fl0m0/KiCad_libs/3dmodels/Capacitor_SMD_Wurth/CP_Wurth_WCAP-ASLI-D4L5.5.step

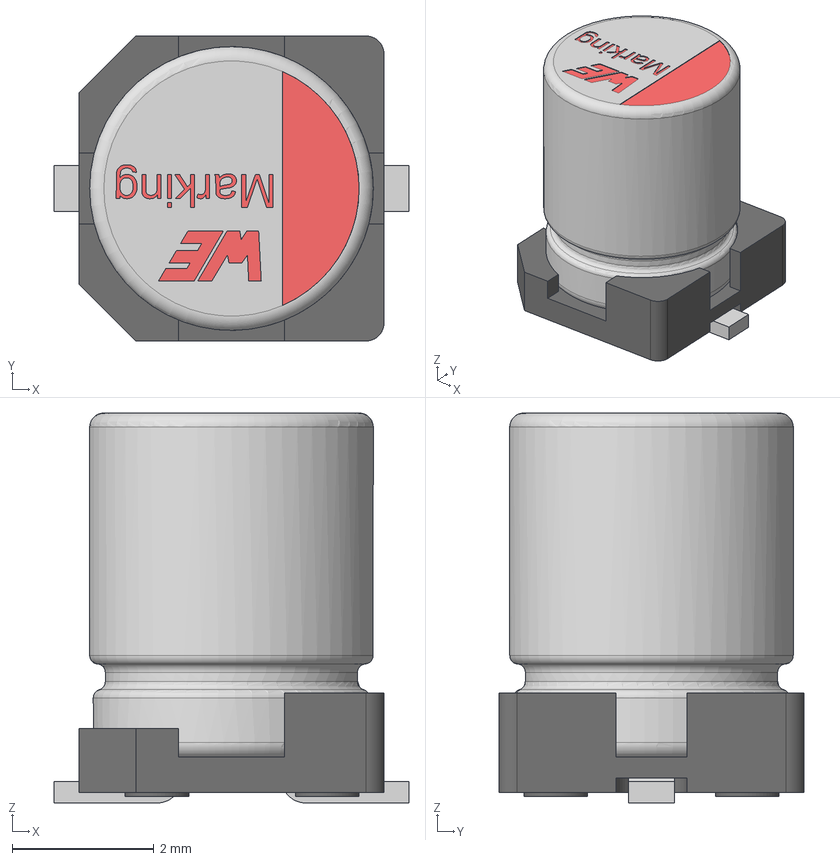
[picture p1: CAD file, 2025-03-17]
3dmodels/Capacitor_SMD_Wurth/CP_Wurth_WCAP-ASLI-D4L5.5.step
5.00 x 4.30 x 5.50 mm
