fl0m0/KiCad_libs/3dmodels/Connector/Harwin_M20-7810445.step

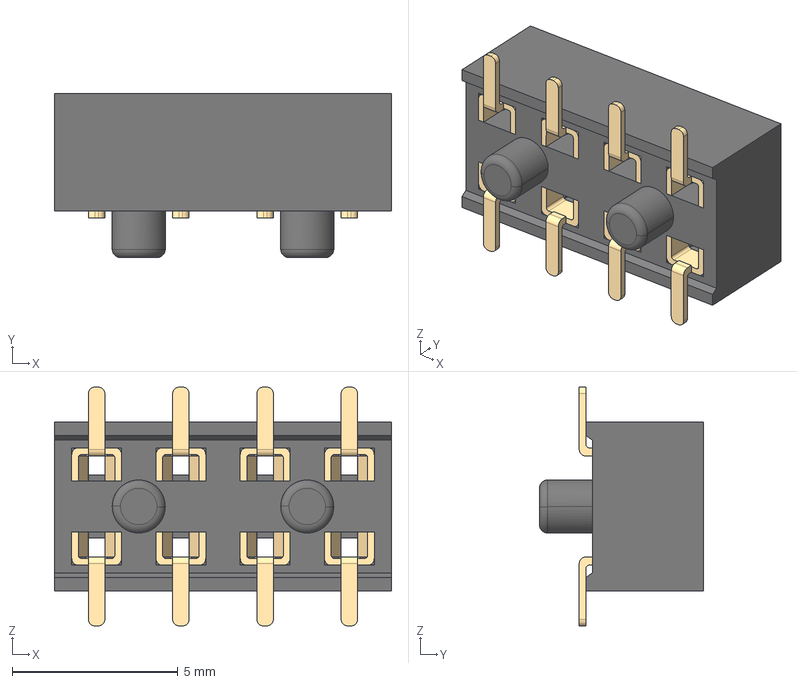
[picture p2: CAD file, 2026-03-09]
3dmodels/Connector/Harwin_M20-7810445.step
10.2 x 4.95 x 7.20 mm
