fl0m0/KiCad_libs/3dmodels/Display_7Segment_User/SA-SC56-11.STEP

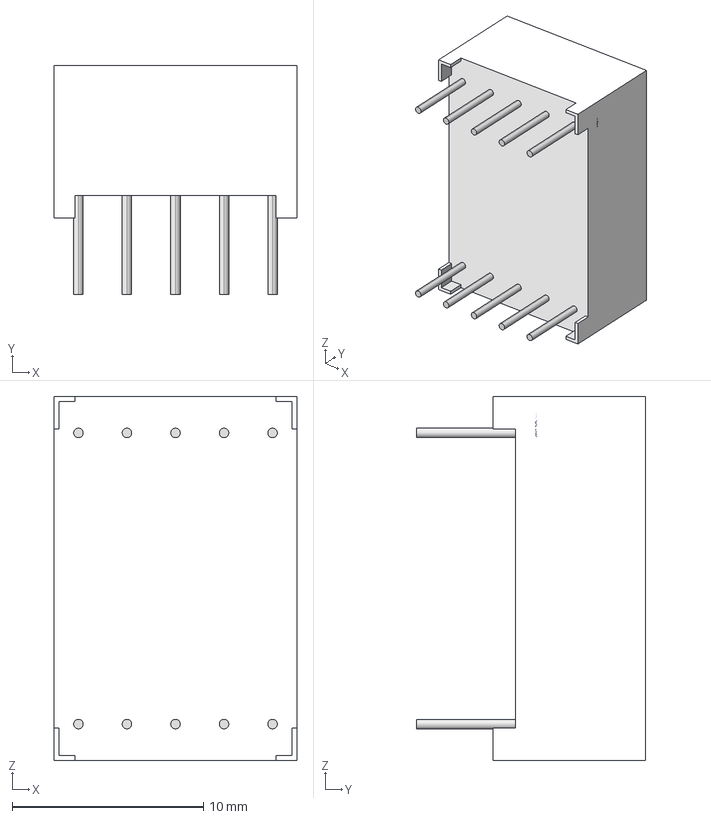
[picture p3: CAD file, 2024-05-18]
3dmodels/Display_7Segment_User/SA-SC56-11.STEP
12.7 x 12.0 x 19.1 mm
