fl0m0/KiCad_libs/3dmodels/Display_User/SSD1306_0.96_OLED.STEP

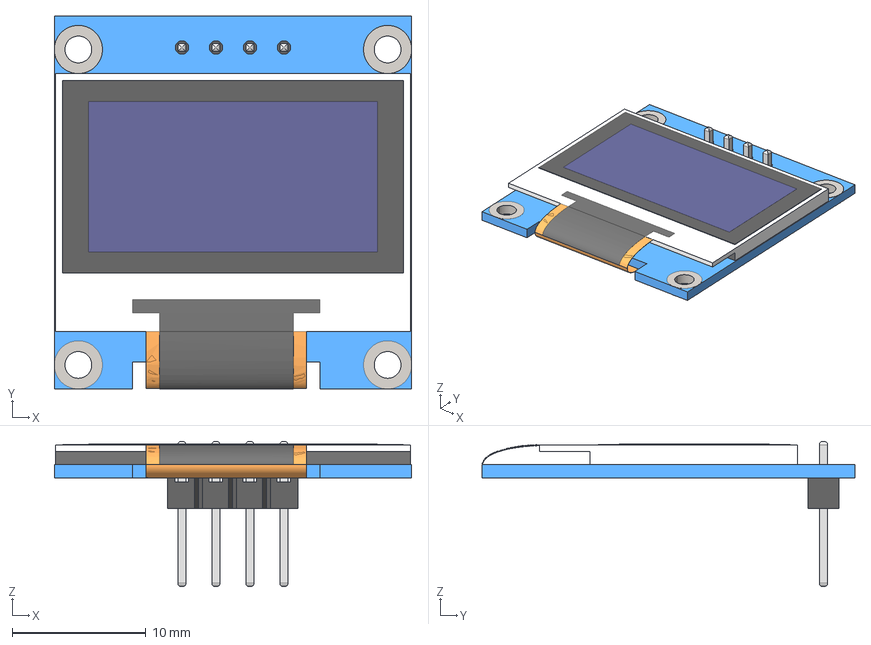
[picture p4: CAD file, 2026-02-07]
3dmodels/Display_User/SSD1306_0.96_OLED.STEP
26.7 x 27.9 x 10.8 mm
48C996C4-7BE9-43D2-ACA2-395FA91DDC79
48C996C4-7BE9-43D2-ACA2-395FA91DDC080
48C996C4-7BE9-43D2-ACA2-395FA91DDC081
48C996C4-7BE9-43D2-ACA2-395FA91DDC082
