fl0m0/KiCad_libs/3dmodels/Inductor/L_Bourns_SRP4020TA_4.45x4.06mm.step

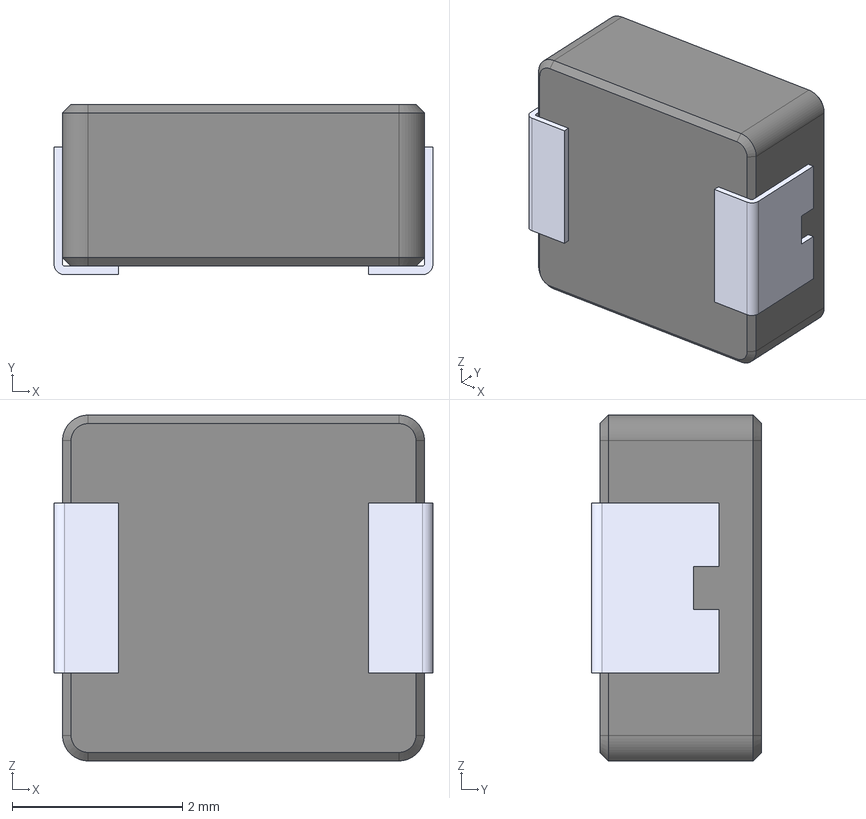
[picture p5: CAD file, 2026-02-13]
3dmodels/Inductor/L_Bourns_SRP4020TA_4.45x4.06mm.step
4.45 x 2.00 x 4.06 mm
SRP4020TA-2R2M
SRP4020TA-2R2M001
SRP4020TA-2R2M002
