fl0m0/KiCad_libs/3dmodels/LED/LTST-C191KFKT_Yellow.step

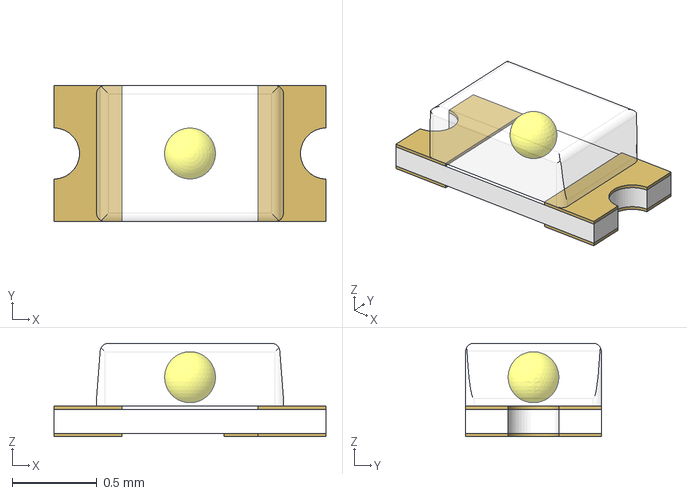
[picture p6: CAD file, 2023-05-30]
3dmodels/LED/LTST-C191KFKT_Yellow.step
1.60 x 0.8 x 0.55 mm
