fl0m0/KiCad_libs/3dmodels/LogicBricks/Wuerth_WR-PHD_61300421821.stp

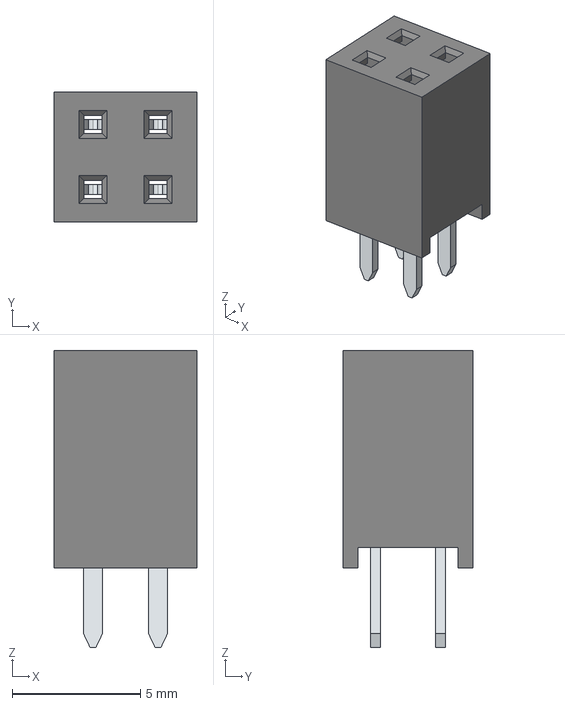
[picture p7: CAD file, 2024-05-12]
3dmodels/LogicBricks/Wuerth_WR-PHD_61300421821.stp
5.58 x 5.08 x 11.6 mm
6130xx21821_PIN x 4
