fl0m0/KiCad_libs/3dmodels/Mechanical/PIHER_5214.step

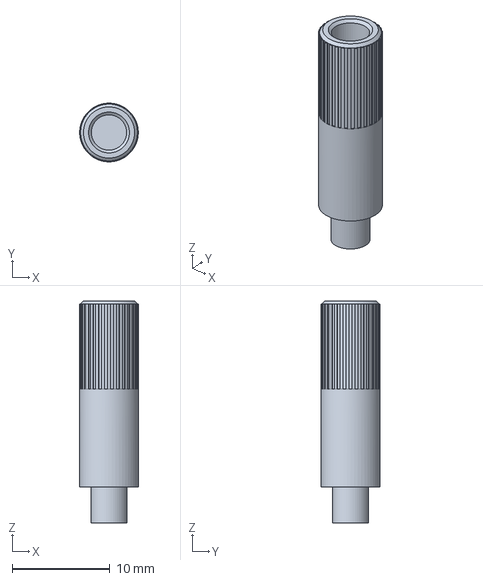
[picture p8: CAD file, 2024-05-27]
3dmodels/Mechanical/PIHER_5214.step
6.00 x 6.00 x 22.7 mm
