fl0m0/KiCad_libs/3dmodels/Module/BTT_TMC2209-V1.2.STEP

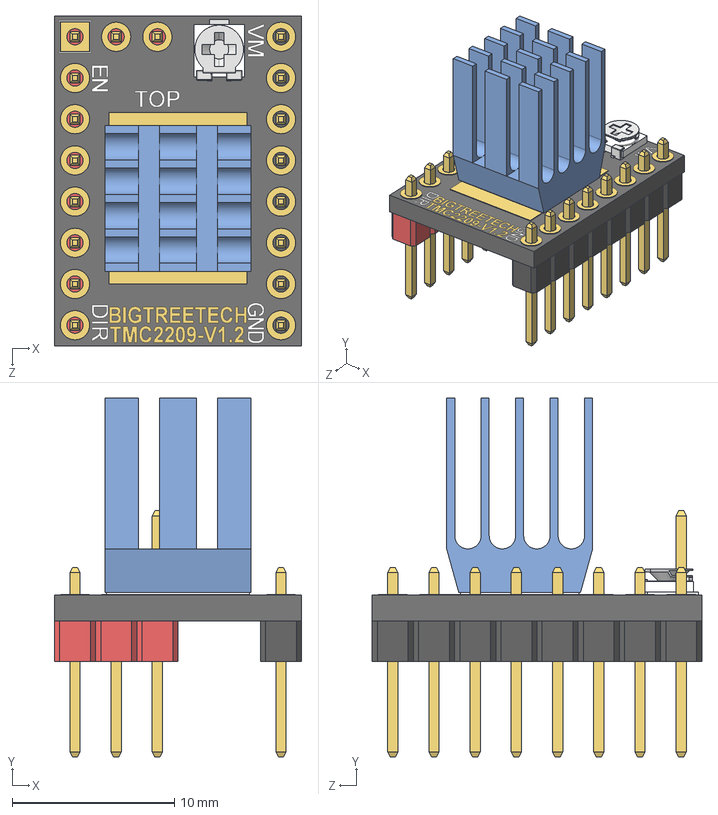
[picture p9: CAD file, 2025-10-17]
3dmodels/Module/BTT_TMC2209-V1.2.STEP
15.2 x 22.1 x 20.3 mm
TMC2209_board
Pin_Header_1x2_red
Pin_Header_1x8_red
Pin_Header_1x8_black
EVM-3E___ _________
TMC2209_heatsink
