fl0m0/KiCad_libs/3dmodels/Package_DFN_QFN/Silicon_Labs_QFN-32-1EP_5x5mm_P0.5mm_EP3.6x3.6mm.step

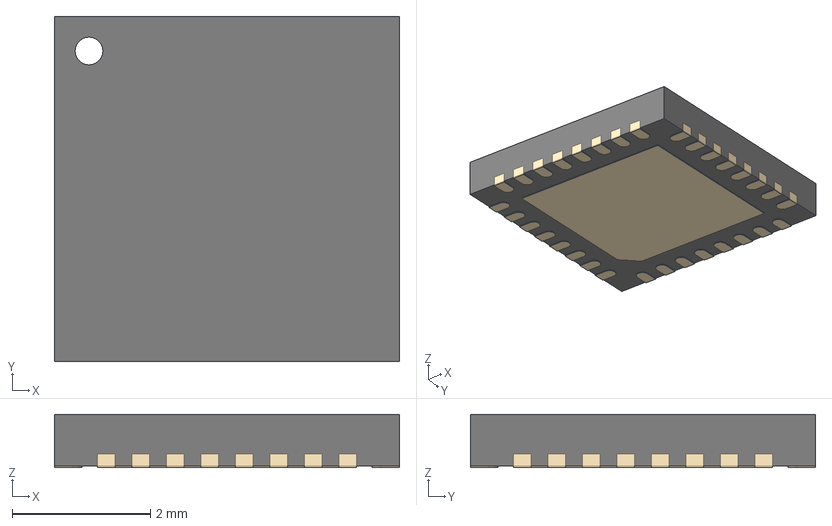
[picture p10: CAD file, 2026-03-19]
3dmodels/Package_DFN_QFN/Silicon_Labs_QFN-32-1EP_5x5mm_P0.5mm_EP3.6x3.6mm.step
5.00 x 5.00 x 0.77 mm
