fl0m0/KiCad_libs/3dmodels/Package_SO/HTSSOP28_EP.STEP

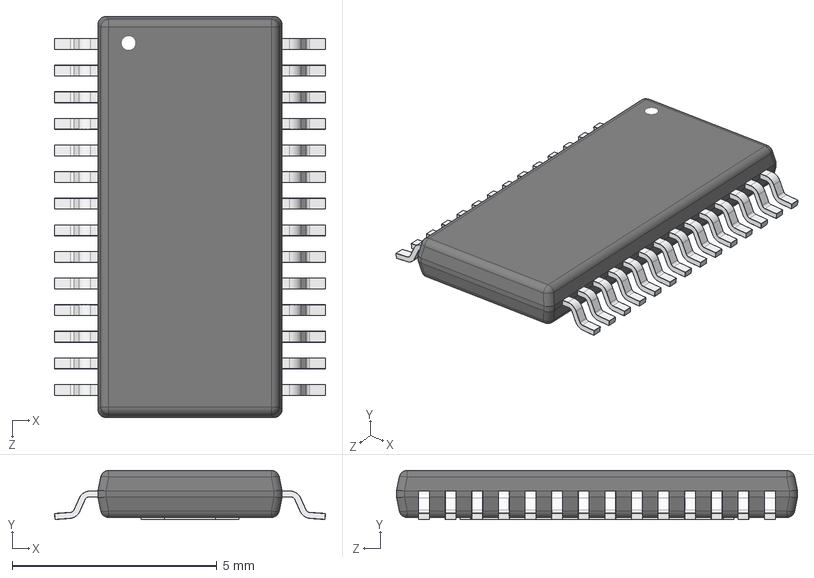
[picture p11: CAD file, 2023-05-30]
3dmodels/Package_SO/HTSSOP28_EP.STEP
6.62 x 1.20 x 9.80 mm
PWP_Koerper
PWP_PIN x 28
PWP_THERM_PIN
