fl0m0/KiCad_libs/3dmodels/Package_SON/Infineon_PG-TDSON-8-33.step

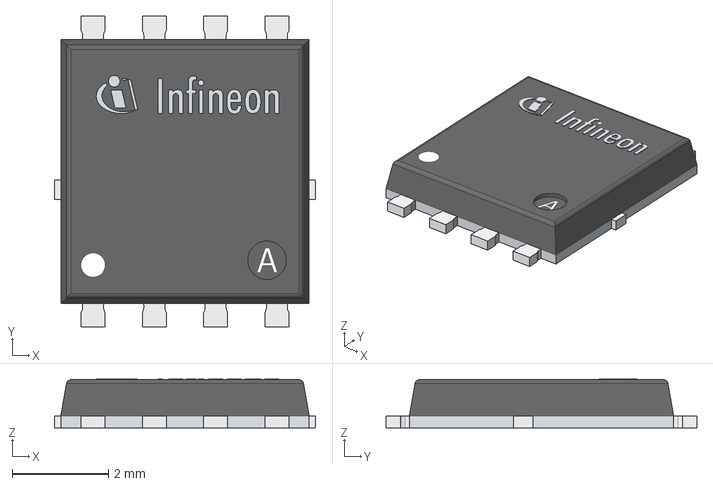
[picture p12: CAD file, 2025-03-15]
3dmodels/Package_SON/Infineon_PG-TDSON-8-33.step
5.41 x 6.44 x 1.01 mm
