fl0m0/KiCad_libs/3dmodels/Potentiometer/PIHER_PT15-NV17.step

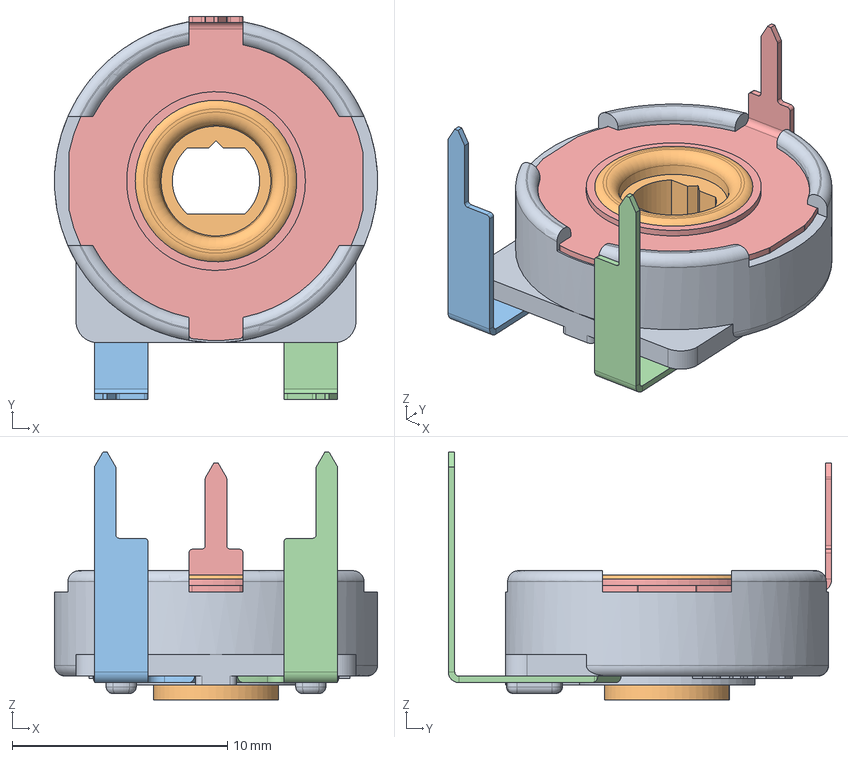
[picture p13: CAD file, 2024-05-25]
3dmodels/Potentiometer/PIHER_PT15-NV17.step
15.0 x 17.8 x 11.5 mm
PT15NV17-CARCASA_REMACHADA
PT15NV17-PORTACURSOR_REMACHADO
PT15NV17-TERMINAL DERECHO
PT15NV17-TERMINAL IZQUIERDO
PT15NV17-COLECTOR_PREDETERMINADA
