fl0m0/KiCad_libs/3dmodels/Relay/jw1.step

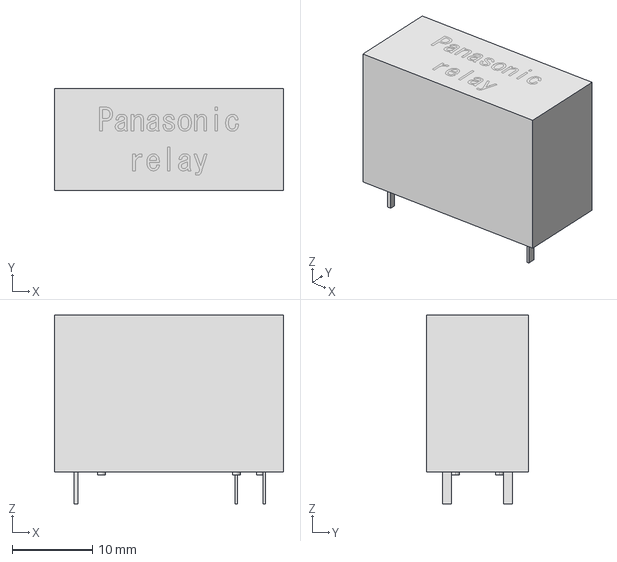
[picture p14: CAD file, 2023-05-30]
3dmodels/Relay/jw1.step
28.6 x 12.8 x 23.6 mm
