fl0m0/KiCad_libs/3dmodels/Rotary_Encoder/PEC11R-4215F-Sxxxx.step

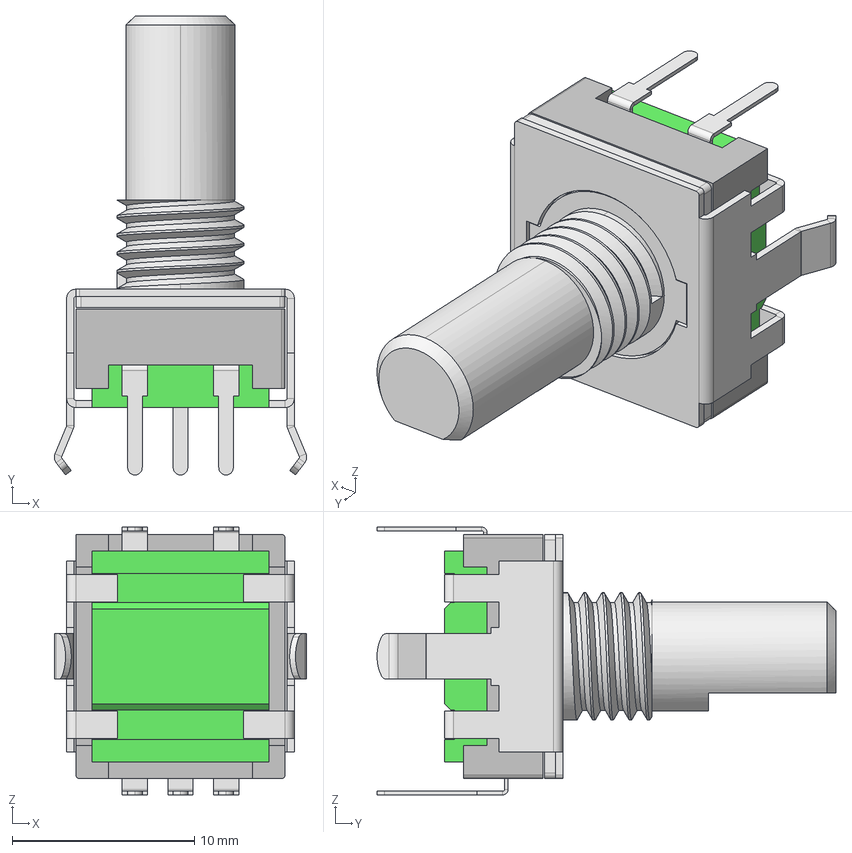
[picture p15: CAD file, 2026-02-07]
3dmodels/Rotary_Encoder/PEC11R-4215F-Sxxxx.step
13.9 x 25.2 x 14.7 mm
PEC11R-4215F-S0024
PEC11R-4215F-S0025
PEC11R-4215F-S0026
PEC11R-4215F-S0027
PEC11R-4215F-S0028
PEC11R-4215F-S0029
PEC11R-4215F-S0030
PEC11R-4215F-S0031
PEC11R-4215F-S0032
