fl0m0/KiCad_libs/3dmodels/Switch/OMRON_B3FS_100x.step

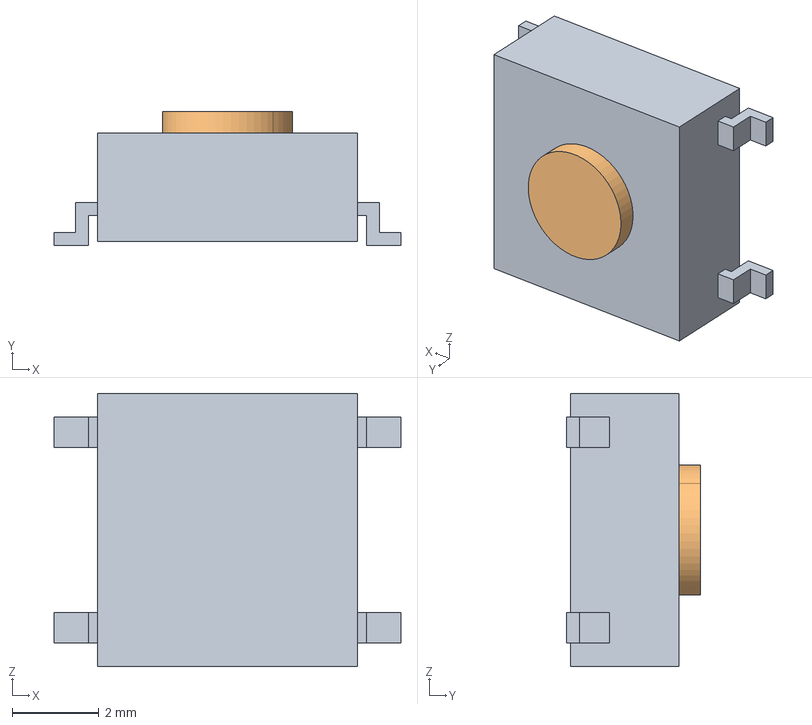
[picture p16: CAD file, 2025-03-22]
3dmodels/Switch/OMRON_B3FS_100x.step
8.00 x 3.10 x 6.30 mm
B3FS_1000_BASE
B3FS_1000_BUTTON
