fl0m0/KiCad_libs/3dmodels/Transformer/Wuerth_WE-FB_3751_EE35_18_10.step

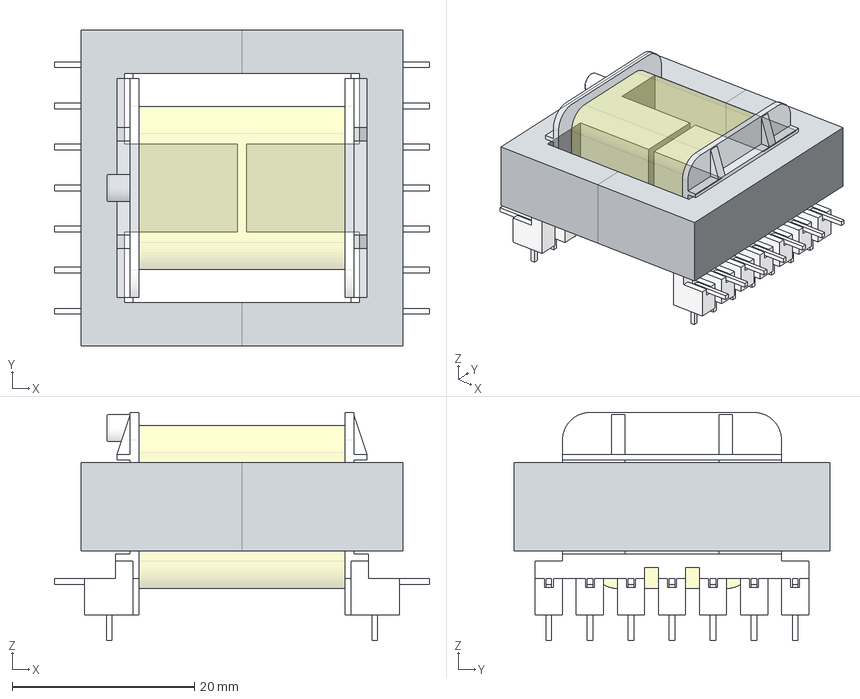
[picture p17: CAD file, 2025-03-12]
3dmodels/Transformer/Wuerth_WE-FB_3751_EE35_18_10.step
41.1 x 34.6 x 25.0 mm
Bobbin_EE-35
core x 2
