fl0m0/KiCad_libs/3dmodels/Capacitor_SMD_Wurth/CP_Wurth_WCAP-ASLI-D8L6.5.step

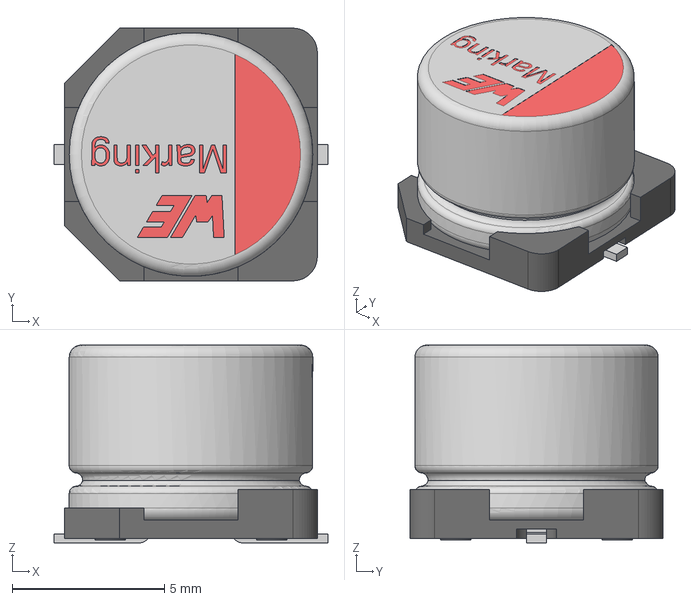
[picture p18: CAD file, 2025-03-17]
3dmodels/Capacitor_SMD_Wurth/CP_Wurth_WCAP-ASLI-D8L6.5.step
9.00 x 8.30 x 6.50 mm
