fl0m0/KiCad_libs/3dmodels/Connector/Wuerth_WR-PHD_61300415721.step

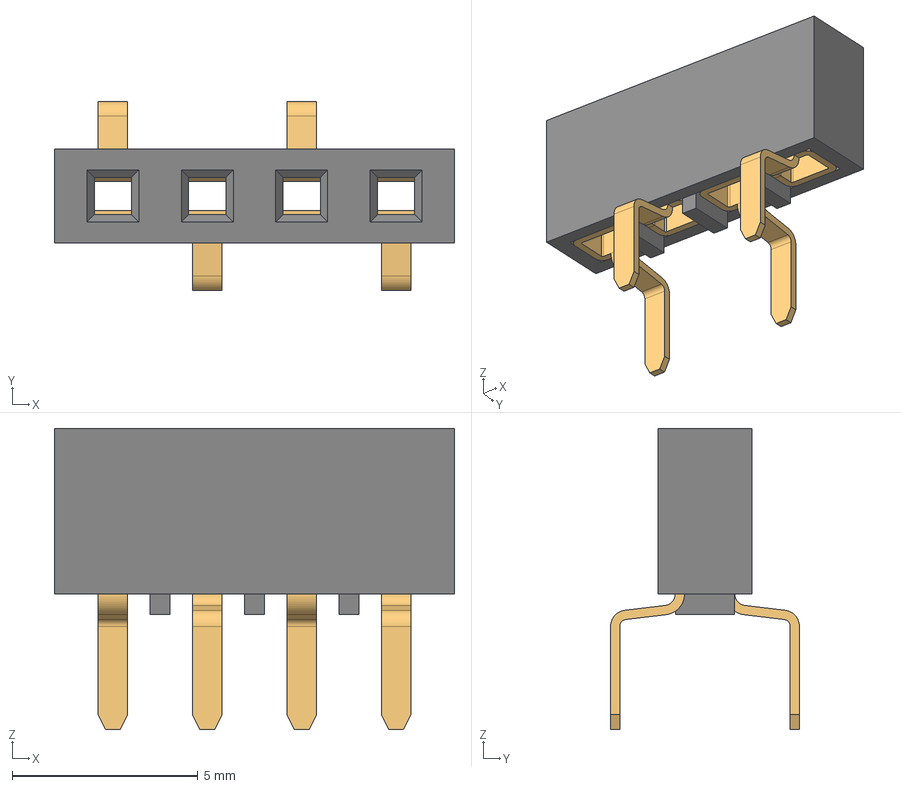
[picture p19: CAD file, 2026-03-08]
3dmodels/Connector/Wuerth_WR-PHD_61300415721.step
10.8 x 5.08 x 8.10 mm
