fl0m0/KiCad_libs/3dmodels/Inductor/L_Wurth_WE-MAPI-4020.step

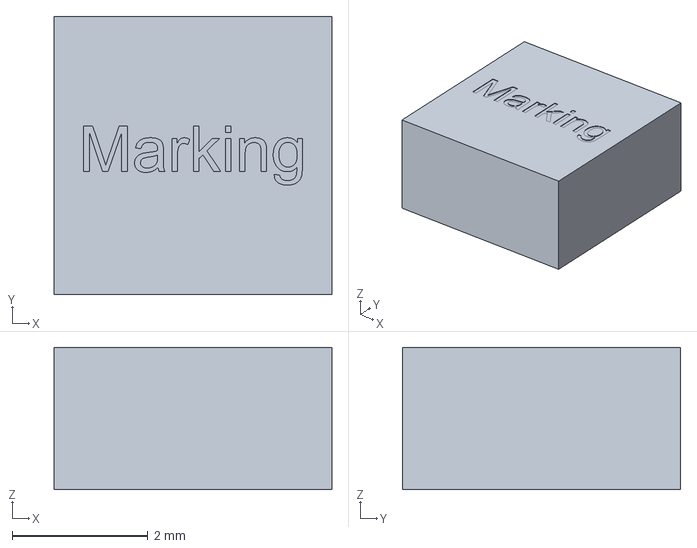
[picture p20: CAD file, 2024-11-29]
3dmodels/Inductor/L_Wurth_WE-MAPI-4020.step
4.10 x 4.10 x 2.10 mm
