fl0m0/KiCad_libs/3dmodels/LED/STW8Q14D.STEP

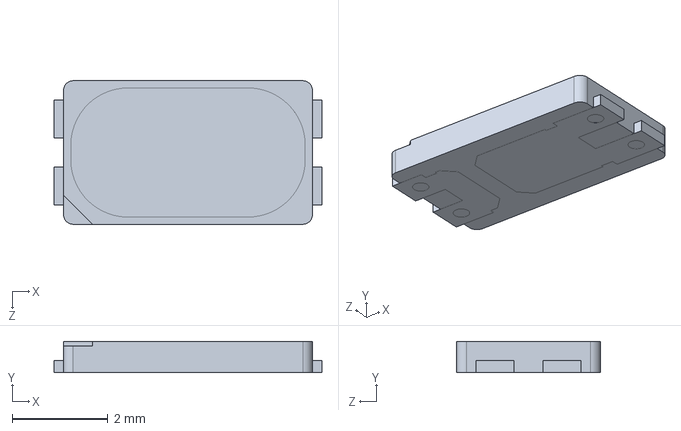
[picture p21: CAD file, 2023-05-30]
3dmodels/LED/STW8Q14D.STEP
5.60 x 0.652 x 3.00 mm
