fl0m0/KiCad_libs/3dmodels/Mechanical/DBG8_CON_Light_Pipe.step

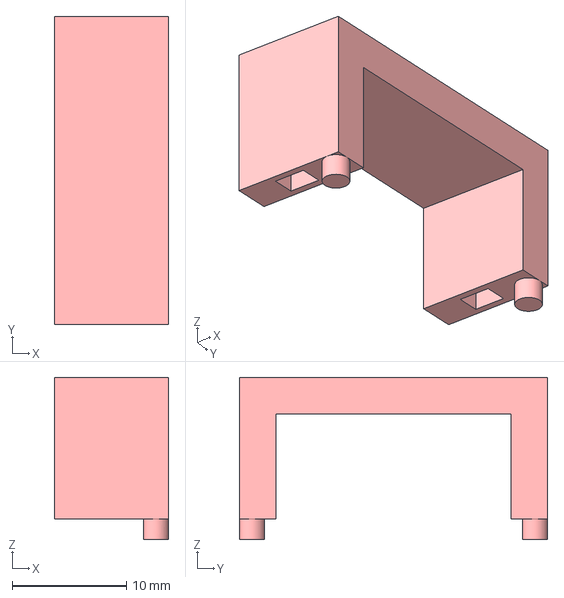
[picture p22: CAD file, 2023-05-30]
3dmodels/Mechanical/DBG8_CON_Light_Pipe.step
10.0 x 27.0 x 14.2 mm
