fl0m0/KiCad_libs/3dmodels/Module/Teensy_lc.stp

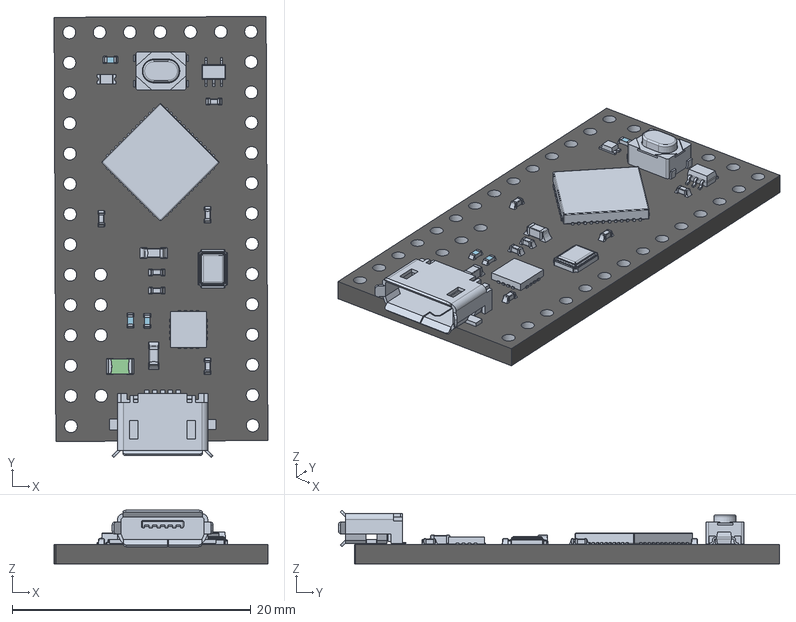
[picture p23: CAD file, 2023-05-30]
3dmodels/Module/Teensy_lc.stp
17.9 x 37.0 x 4.49 mm
board
micro_usb_plastic (1)
micro_usb_shell (1)
lead
diode_0402 v1 x 4
cap0603_03 v3 x 2
qfn48 v2
cap0402 v2 x 6
resistor_0805 v2
smt_led_0603 v2
package
lead (1)
