fl0m0/KiCad_libs/3dmodels/Package_DFN_QFN/VQFN-20_3.5x4.5mm.STEP

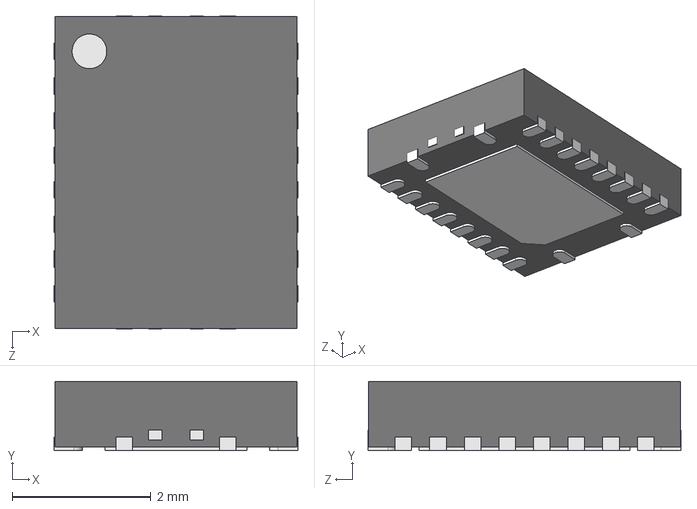
[picture p24: CAD file, 2023-05-30]
3dmodels/Package_DFN_QFN/VQFN-20_3.5x4.5mm.STEP
3.52 x 1.00 x 4.52 mm
