fl0m0/KiCad_libs/3dmodels/Package_SO/SO-8_3.9x4.9mm_P1.27mm.STEP

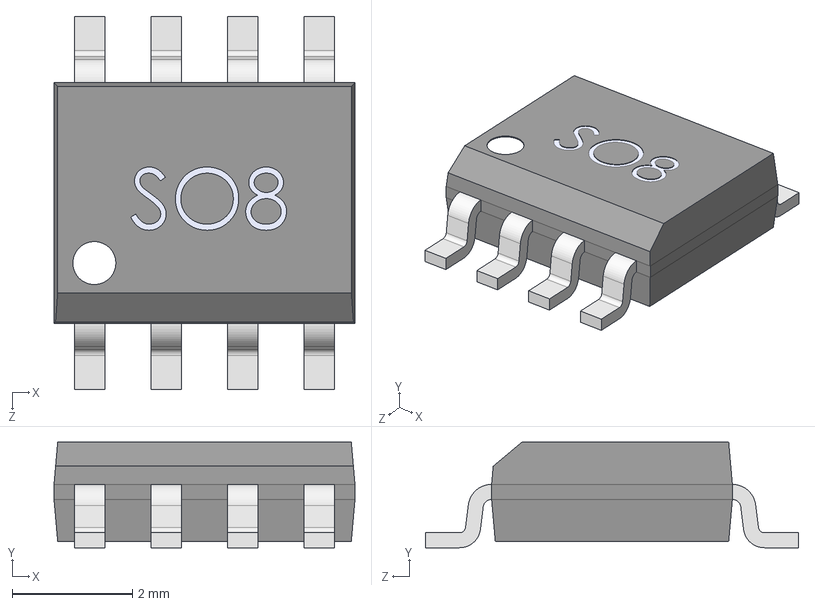
[picture p25: CAD file, 2023-05-30]
3dmodels/Package_SO/SO-8_3.9x4.9mm_P1.27mm.STEP
5.00 x 1.75 x 6.20 mm
