fl0m0/KiCad_libs/3dmodels/Package_SON/WSON-12-1EP_3x2mm_P0.5mm_EP1x2.65.step

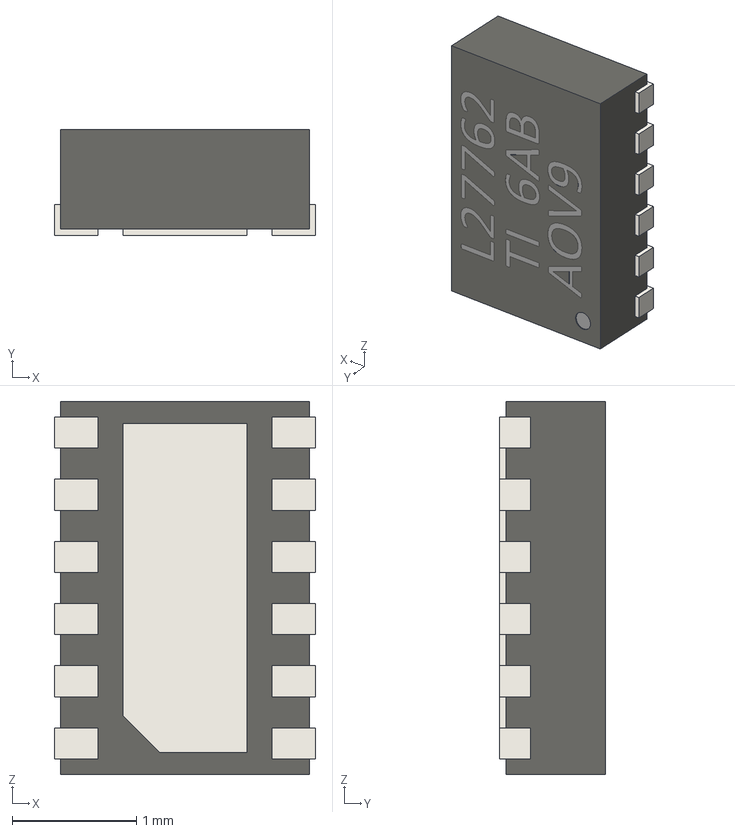
[picture p26: CAD file, 2023-06-18]
3dmodels/Package_SON/WSON-12-1EP_3x2mm_P0.5mm_EP1x2.65.step
2.10 x 0.85 x 3.00 mm
