fl0m0/KiCad_libs/3dmodels/Potentiometer/PDB12-H4301-xF.stp

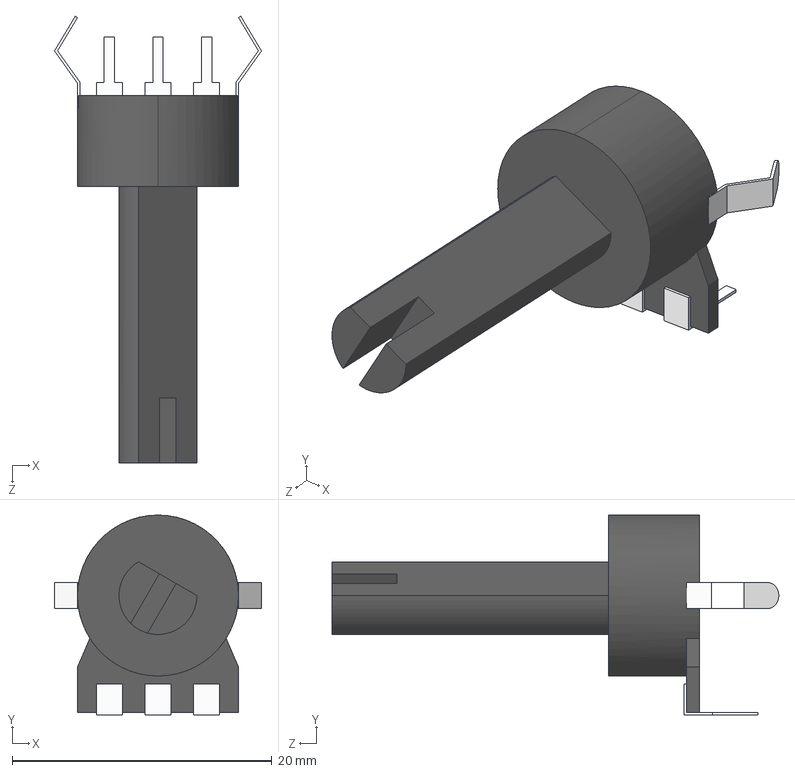
[picture p27: CAD file, 2023-05-30]
3dmodels/Potentiometer/PDB12-H4301-xF.stp
15.9 x 15.4 x 34.4 mm
