fl0m0/KiCad_libs/3dmodels/Relay/Relay_SPST_Panasonic_JW1_FormA.step

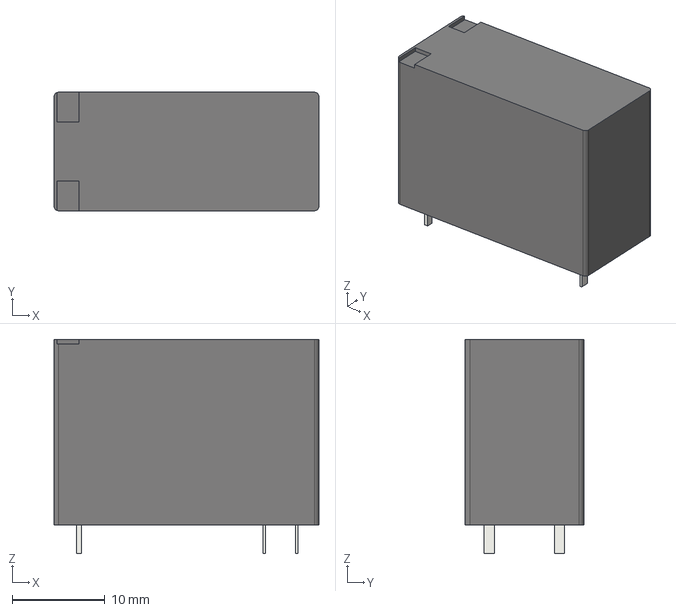
[picture p28: CAD file, 2023-05-30]
3dmodels/Relay/Relay_SPST_Panasonic_JW1_FormA.step
28.6 x 12.8 x 23.1 mm
