fl0m0/KiCad_libs/3dmodels/Switch/CUI_DEVICES_MSS-102568-14A-90-D005.step

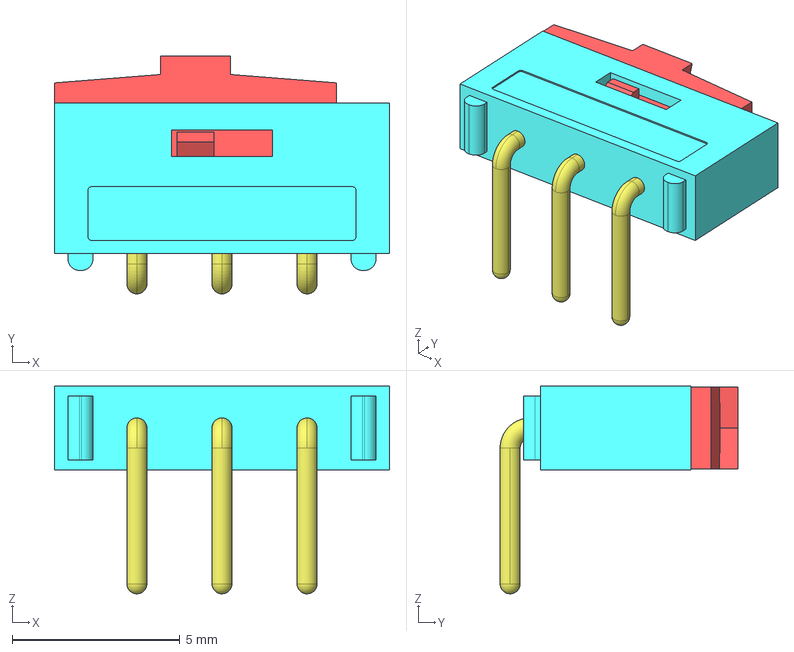
[picture p29: CAD file, 2024-12-01]
3dmodels/Switch/CUI_DEVICES_MSS-102568-14A-90-D005.step
10.0 x 7.10 x 6.20 mm
CUI_DEVICES_MSS-102568-14A-90-D
CUI_DEVICES_MSS-102568-14A-90-D001
CUI_DEVICES_MSS-102568-14A-90-D002
CUI_DEVICES_MSS-102568-14A-90-D003
CUI_DEVICES_MSS-102568-14A-90-D004
