fl0m0/KiCad_libs/3dmodels/Capacitor_SMD_Wurth/CP_Wurth_WCAP-ASLI-D12.5L14.step

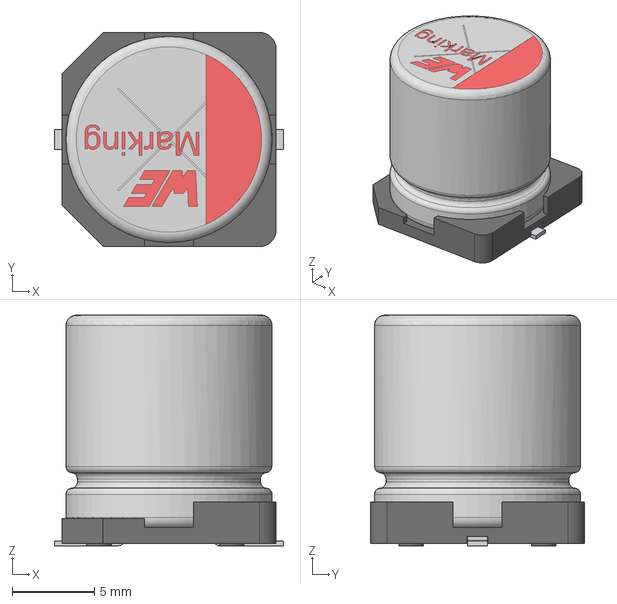
[picture p30: CAD file, 2025-03-17]
3dmodels/Capacitor_SMD_Wurth/CP_Wurth_WCAP-ASLI-D12.5L14.step
13.9 x 13.0 x 14.0 mm
