fl0m0/KiCad_libs/3dmodels/Connector/Wuerth_WR-PHD_61300411821.step

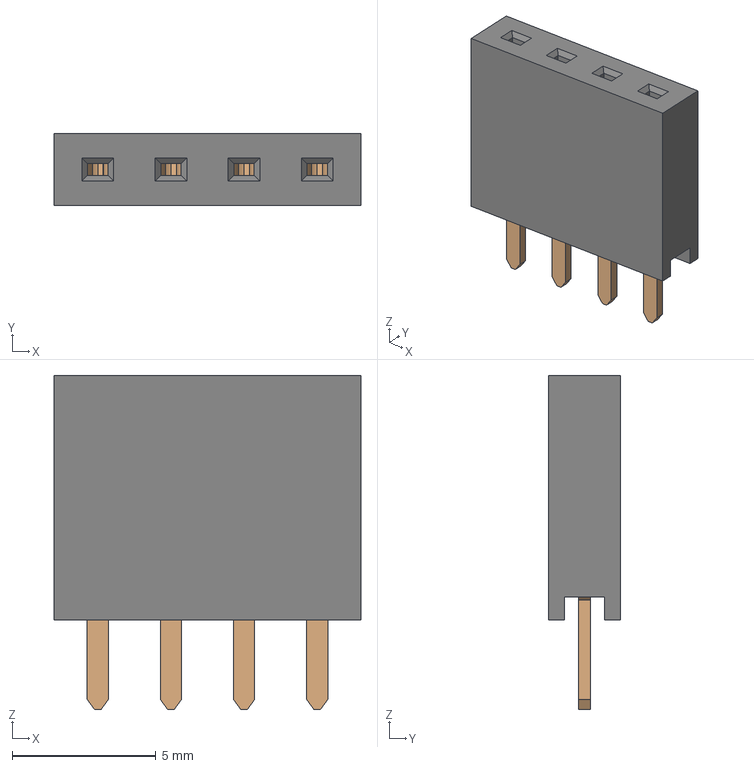
[picture p31: CAD file, 2026-02-21]
3dmodels/Connector/Wuerth_WR-PHD_61300411821.step
10.7 x 2.50 x 11.6 mm
