fl0m0/KiCad_libs/3dmodels/Inductor/L_Wurth_WE-MAPI-4030.step

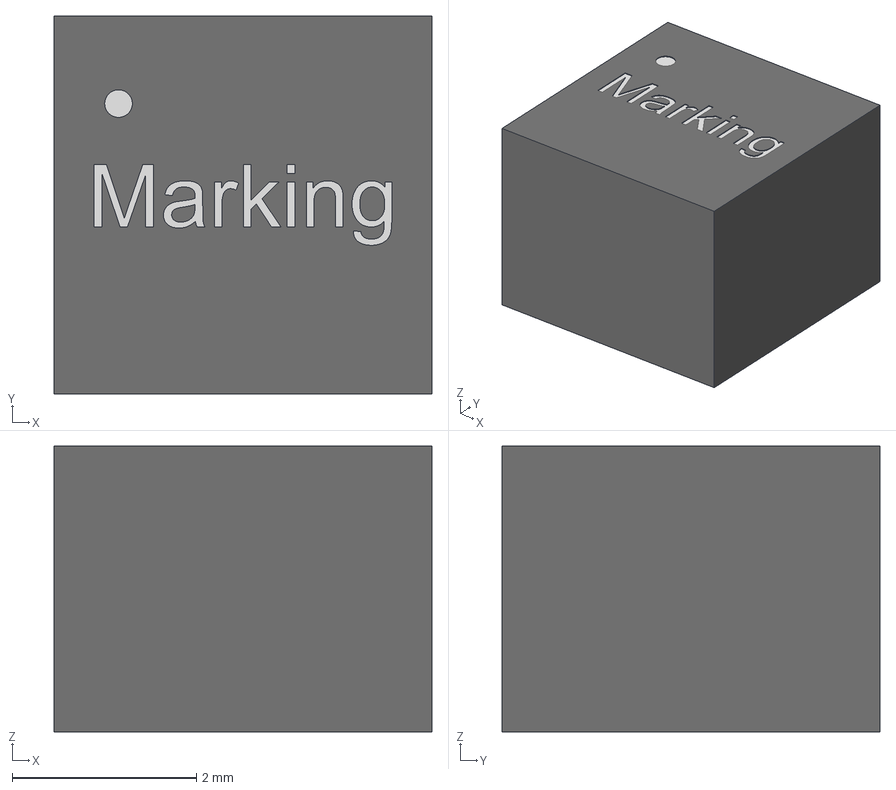
[picture p32: CAD file, 2024-11-12]
3dmodels/Inductor/L_Wurth_WE-MAPI-4030.step
4.10 x 4.10 x 3.10 mm
