fl0m0/KiCad_libs/3dmodels/Mechanical/Light_Pipe_Mount.step

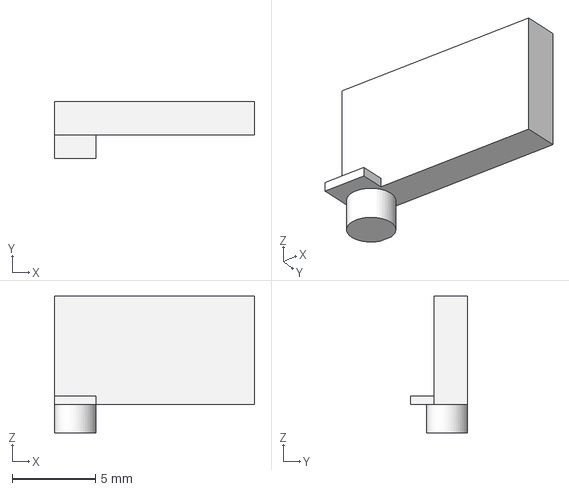
[picture p33: CAD file, 2023-05-30]
3dmodels/Mechanical/Light_Pipe_Mount.step
12.0 x 3.40 x 8.20 mm
