fl0m0/KiCad_libs/3dmodels/Package_SO/SOT23F.STEP

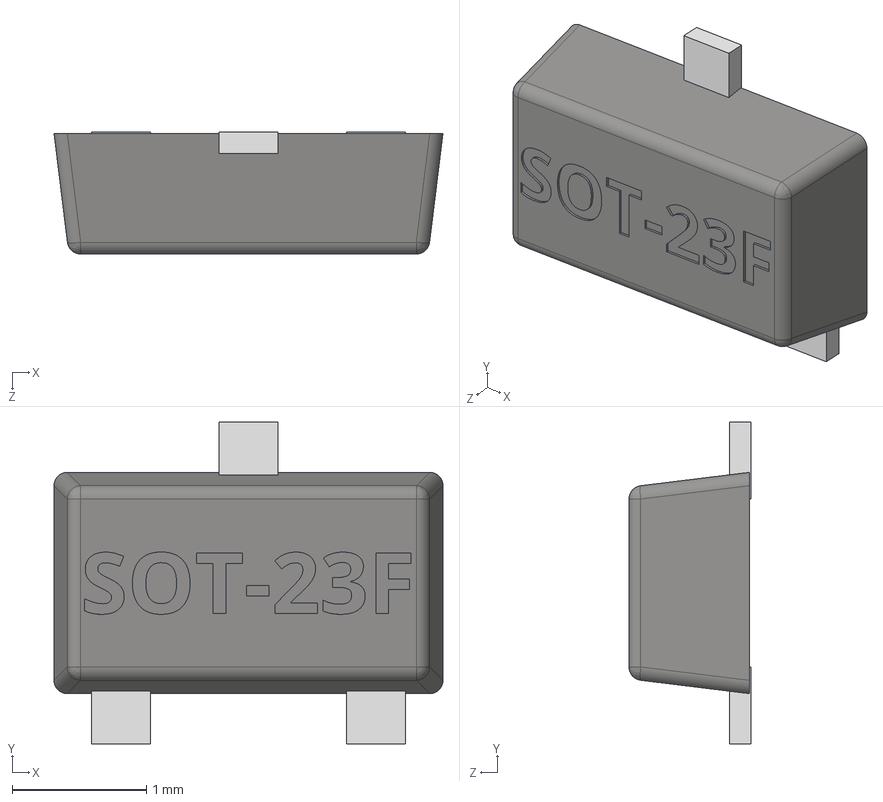
[picture p34: CAD file, 2023-05-30]
3dmodels/Package_SO/SOT23F.STEP
2.90 x 2.40 x 0.91 mm
Pin_3
Cap
Pin_1
Pin_2
