fl0m0/KiCad_libs/3dmodels/Potentiometer/PDB12-M4251-xF.stp

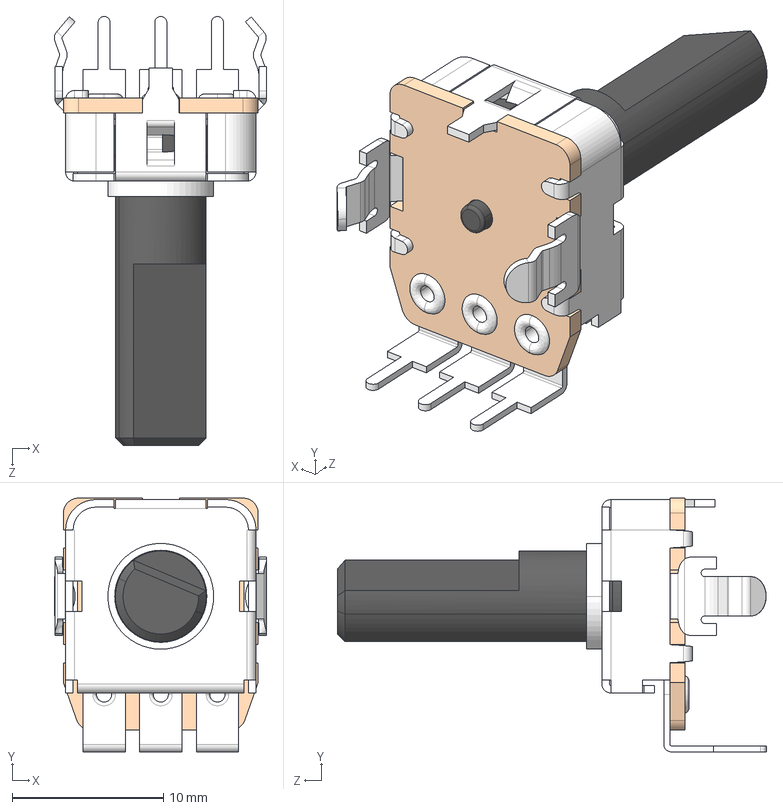
[picture p35: CAD file, 2023-05-30]
3dmodels/Potentiometer/PDB12-M4251-xF.stp
14.1 x 16.8 x 28.4 mm
外壳
轴心
端子 x 3
电阻片
