fl0m0/KiCad_libs/3dmodels/Switch/DP_04.step

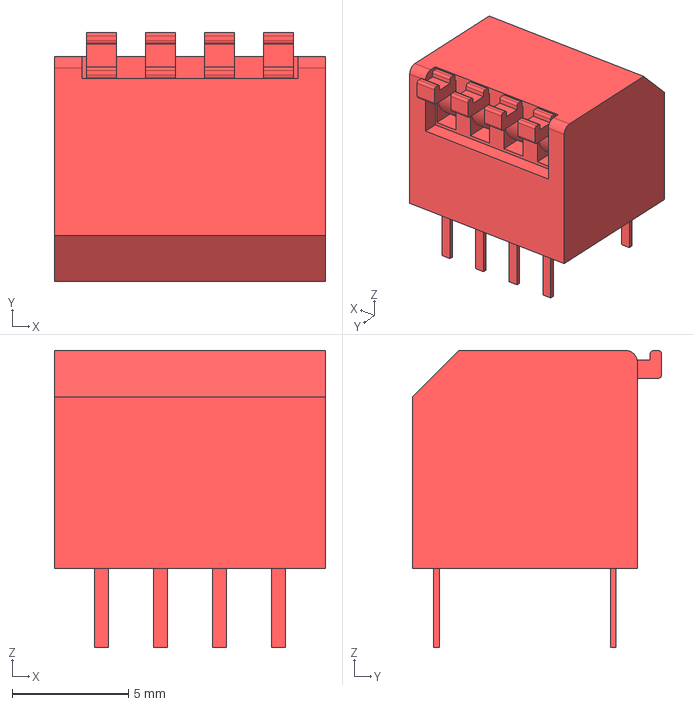
[picture p36: CAD file, 2024-10-24]
3dmodels/Switch/DP_04.step
11.7 x 10.8 x 12.8 mm
