fl0m0/KiCad_libs/3dmodels/Capacitor_SMD_Wurth/CP_Wurth_WCAP-ASLI-D6.3L6.1.step

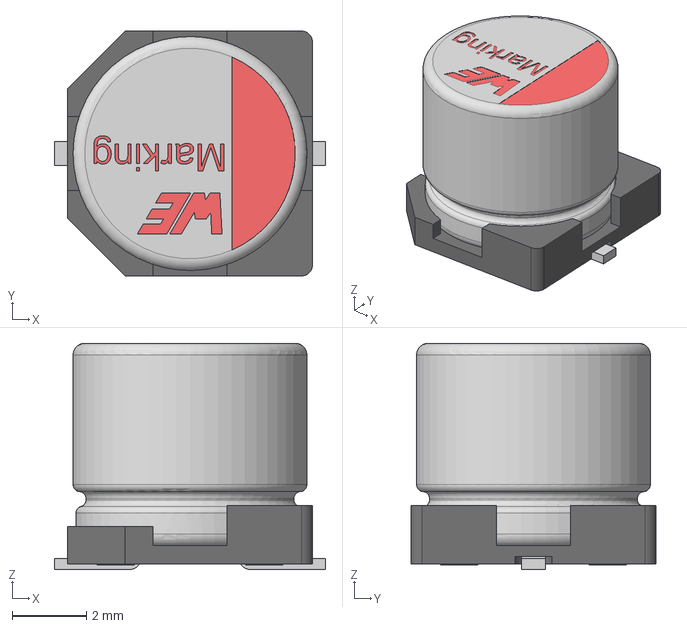
[picture p37: CAD file, 2025-03-17]
3dmodels/Capacitor_SMD_Wurth/CP_Wurth_WCAP-ASLI-D6.3L6.1.step
7.30 x 6.60 x 6.10 mm
