fl0m0/KiCad_libs/3dmodels/Connector/TE_1551631-5.step

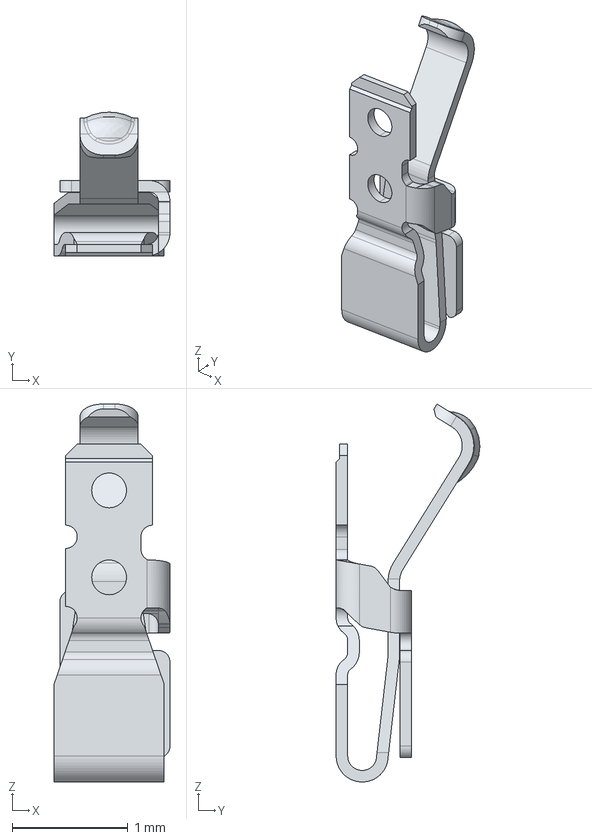
[picture p38: CAD file, 2026-02-10]
3dmodels/Connector/TE_1551631-5.step
1.00 x 1.24 x 3.26 mm
