fl0m0/KiCad_libs/3dmodels/Inductor/WE-MCRI-1040.stp

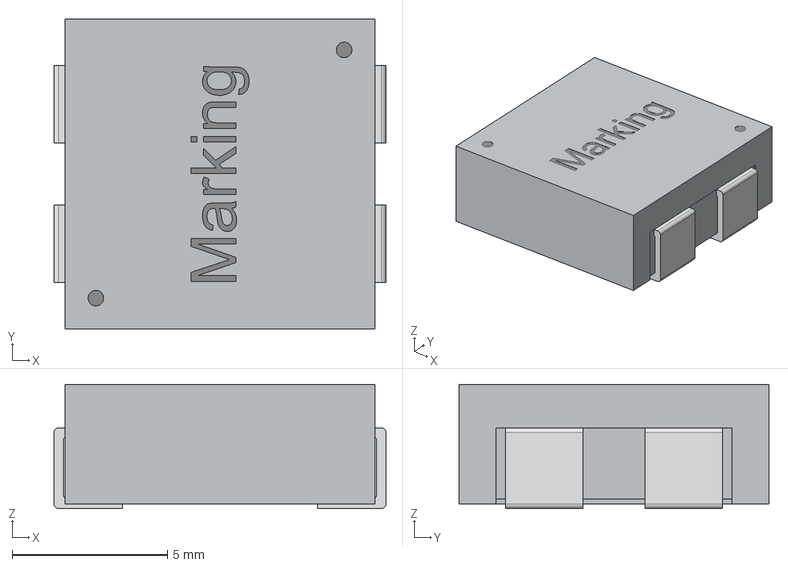
[picture p39: CAD file, 2024-10-24]
3dmodels/Inductor/WE-MCRI-1040.stp
10.7 x 10.0 x 4.00 mm
Contact
