fl0m0/KiCad_libs/3dmodels/Mechanical/PSU_CON_Light_Pipe.step

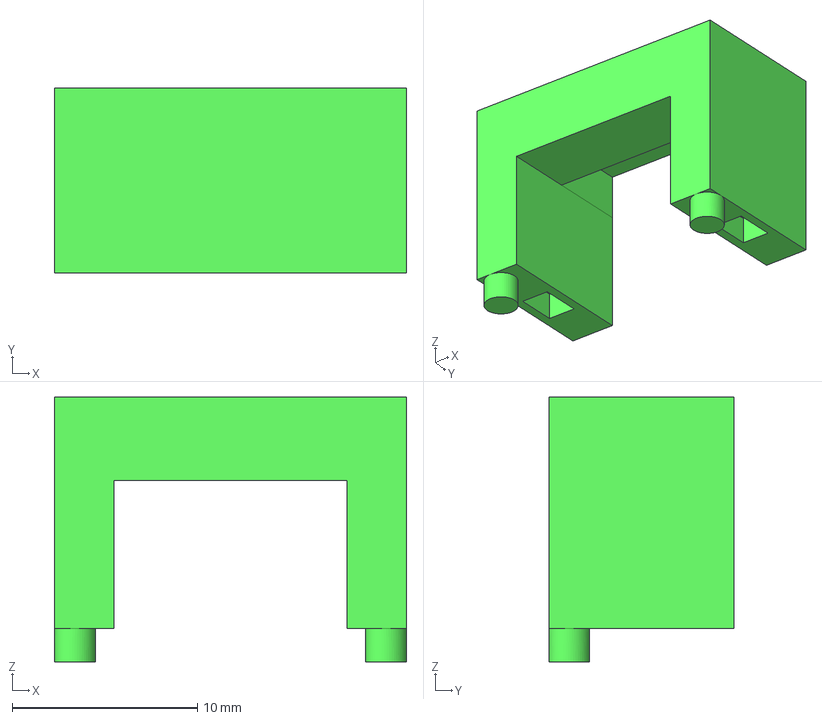
[picture p40: CAD file, 2023-05-30]
3dmodels/Mechanical/PSU_CON_Light_Pipe.step
19.0 x 10.0 x 14.3 mm
