fl0m0/KiCad_libs/3dmodels/Switch/CK_D6RLxxFxLFS.step

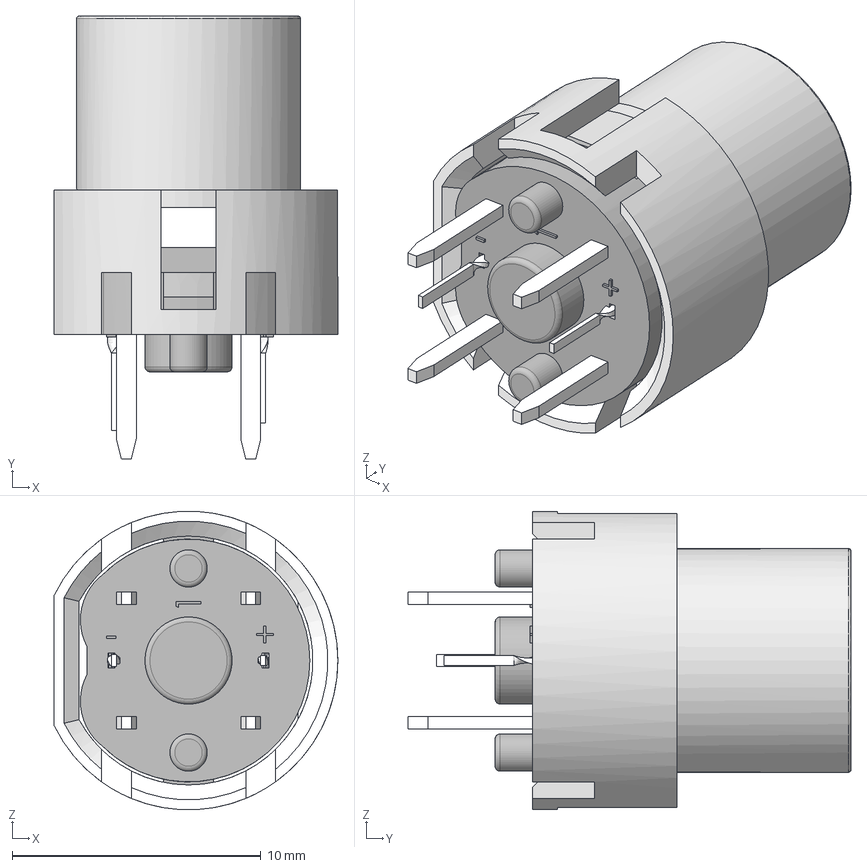
[picture p41: CAD file, 2024-06-22]
3dmodels/Switch/CK_D6RLxxFxLFS.step
11.4 x 17.8 x 12.0 mm
D6RLGNF1LFS_PART1
D6RLGNF1LFS_PART2
D6RLGNF1LFS_PART3
D6RLGNF1LFS_PART4
D6RLGNF1LFS_PART5
D6RLGNF1LFS_PART6
