fl0m0/KiCad_libs/3dmodels/Capacitor_SMD_Wurth/CP_Wurth_WCAP-ASLI-D5L5.5.step

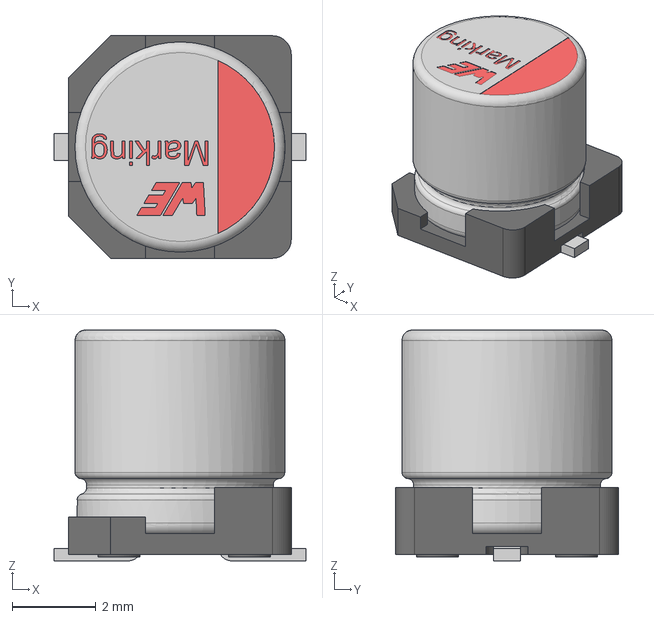
[picture p42: CAD file, 2025-03-17]
3dmodels/Capacitor_SMD_Wurth/CP_Wurth_WCAP-ASLI-D5L5.5.step
6.00 x 5.30 x 5.50 mm
