fl0m0/KiCad_libs/3dmodels/Connector/Adam_Tech_PH2-3B-20-MVP-3345.step

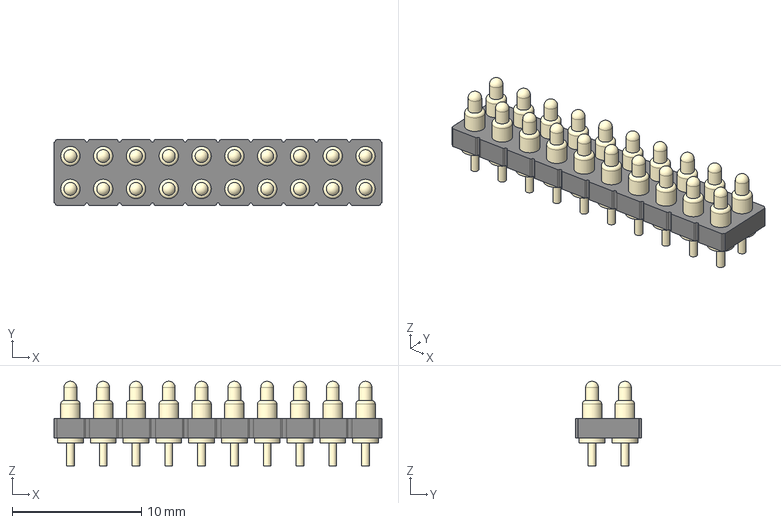
[picture p43: CAD file, 2026-02-05]
3dmodels/Connector/Adam_Tech_PH2-3B-20-MVP-3345.step
25.4 x 5.08 x 6.55 mm
