fl0m0/KiCad_libs/3dmodels/Inductor/WE-PD_1245_STP.stp

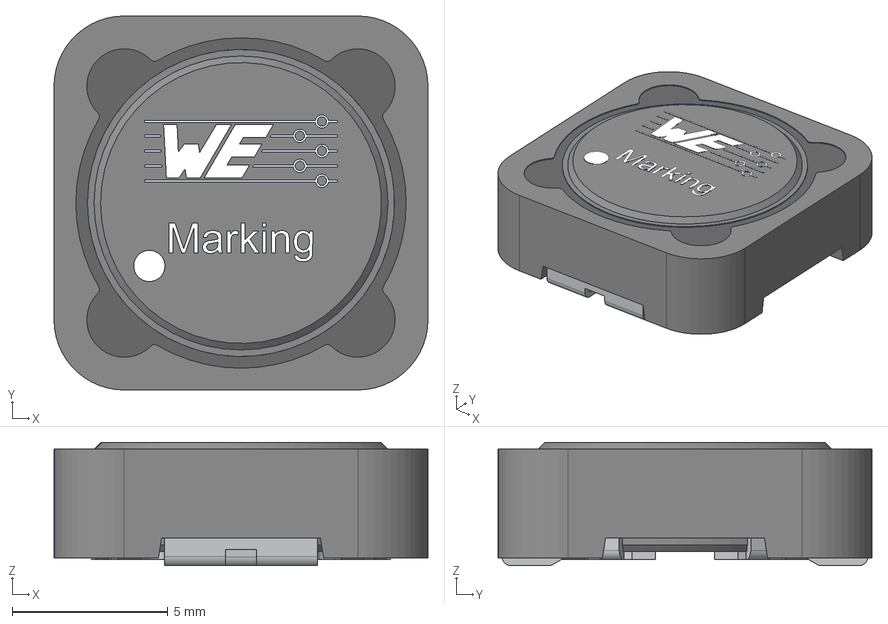
[picture p44: CAD file, 2023-05-30]
3dmodels/Inductor/WE-PD_1245_STP.stp
12.0 x 12.0 x 3.96 mm
Core
ShieldRing
Glue
Leadframe
