fl0m0/KiCad_libs/3dmodels/Mechanical/USB_CON_Light_Pipe.step

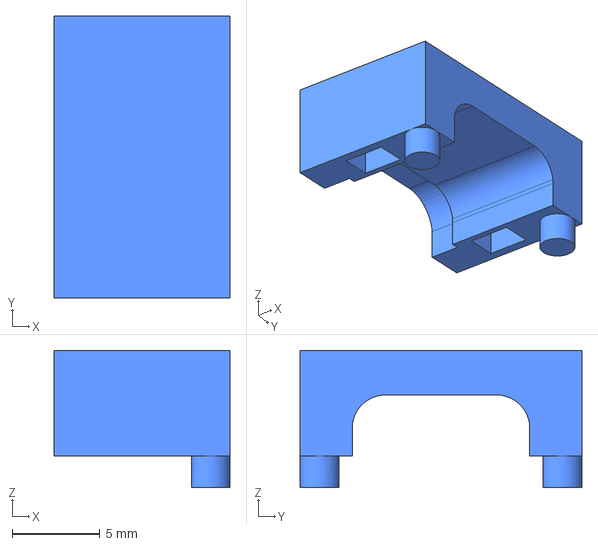
[picture p45: CAD file, 2023-05-30]
3dmodels/Mechanical/USB_CON_Light_Pipe.step
10.0 x 16.0 x 7.80 mm
