fl0m0/KiCad_libs/3dmodels/Switch/Otax_KMx-xx.step

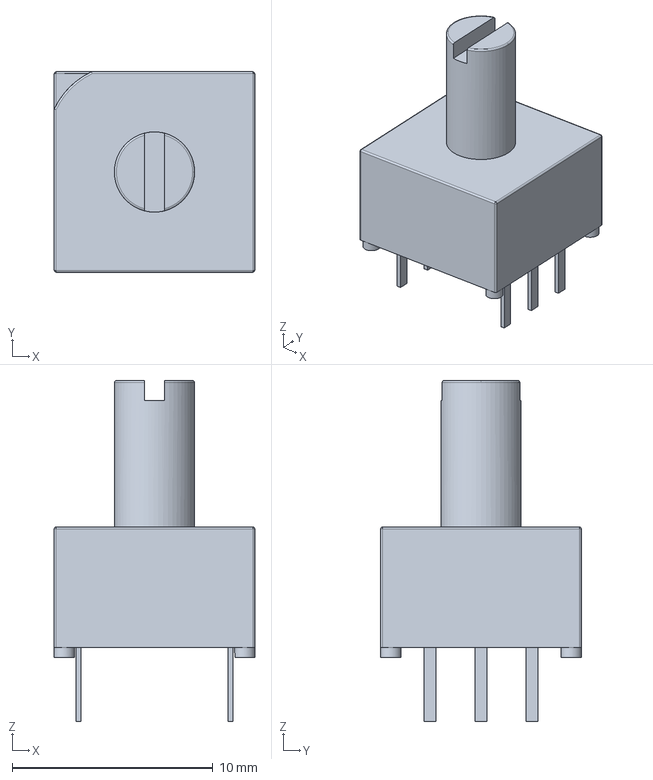
[picture p46: CAD file, 2024-05-31]
3dmodels/Switch/Otax_KMx-xx.step
10.0 x 10.0 x 17.0 mm
