fl0m0/KiCad_libs/3dmodels/Connector/CUI_SJ2-359X-SMT.step

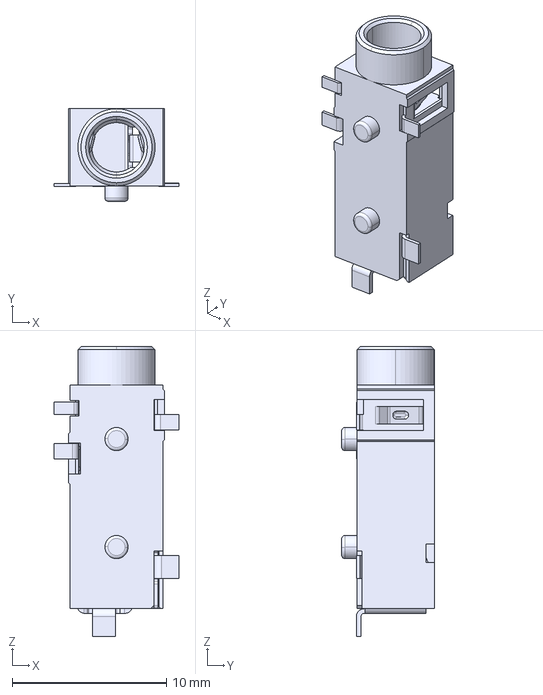
[picture p48: CAD file, 2025-03-22]
3dmodels/Connector/CUI_SJ2-359X-SMT.step
8.10 x 6.00 x 18.8 mm
