fl0m0/KiCad_libs/3dmodels/Switch/100SP1T2B4M6QE.step

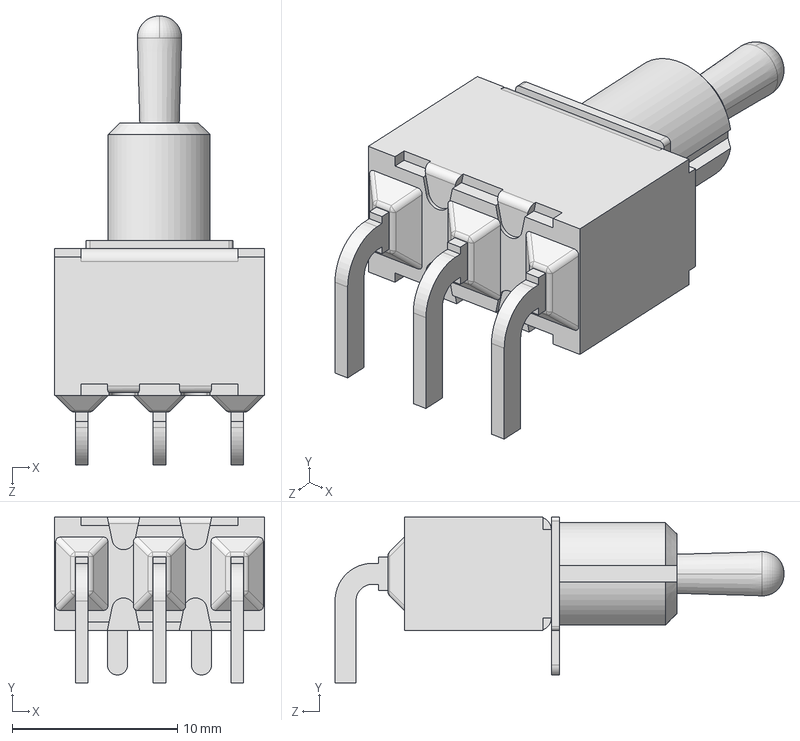
[picture p49: CAD file, 2023-05-30]
3dmodels/Switch/100SP1T2B4M6QE.step
12.7 x 10.0 x 27.2 mm
