fl0m0/KiCad_libs/3dmodels/Connector/Amass_XT30U-F.step

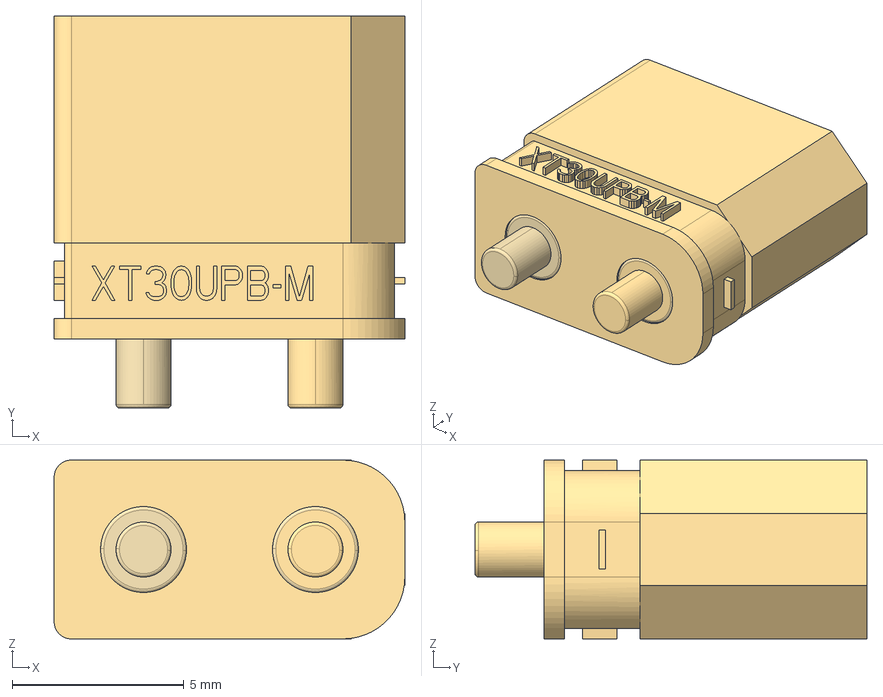
[picture p51: CAD file, 2025-03-17]
3dmodels/Connector/Amass_XT30U-F.step
10.2 x 11.4 x 5.20 mm
