fl0m0/KiCad_libs/3dmodels/Switch/PB06-B-Wx-2RGB-x-x.step

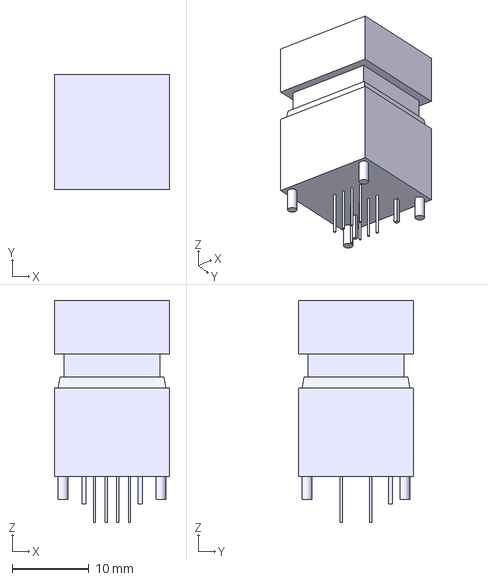
[picture p52: CAD file, 2023-05-30]
3dmodels/Switch/PB06-B-Wx-2RGB-x-x.step
15.0 x 15.0 x 28.9 mm
