fl0m0/KiCad_libs/3dmodels/Connector/Wuerth_WR-PHD_61300821021.step

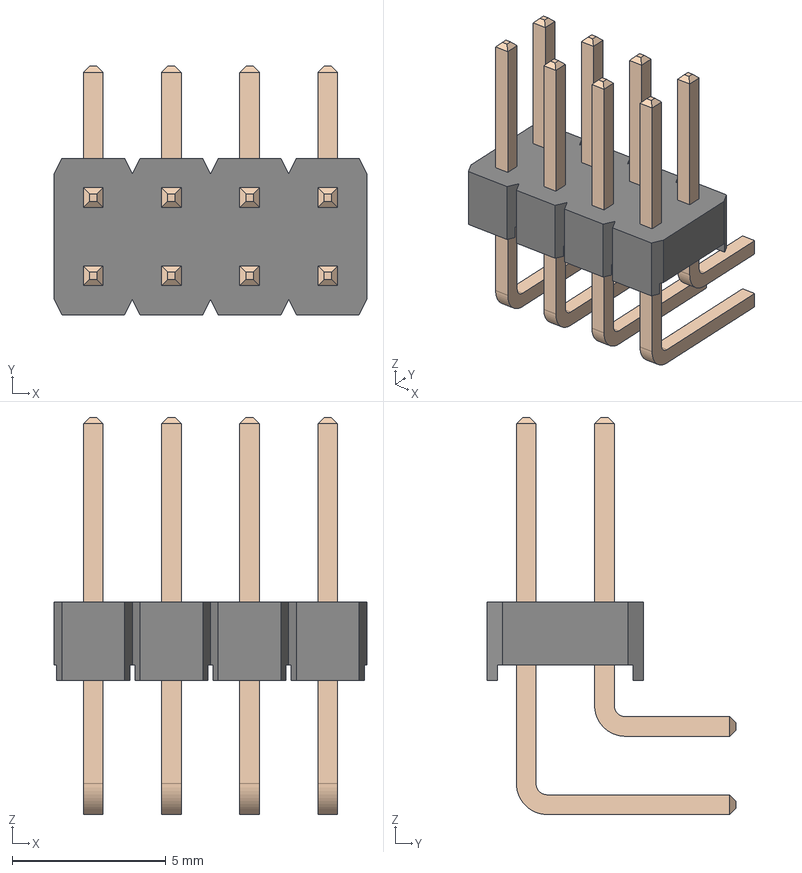
[picture p54: CAD file, 2024-05-18]
3dmodels/Connector/Wuerth_WR-PHD_61300821021.step
10.2 x 8.08 x 12.9 mm
6130xx21021_PIN x 4
6130xx21021_PIN_G x 4
