fl0m0/KiCad_libs/3dmodels/Connector/Wuerth_WR-PHD_613008243121.step

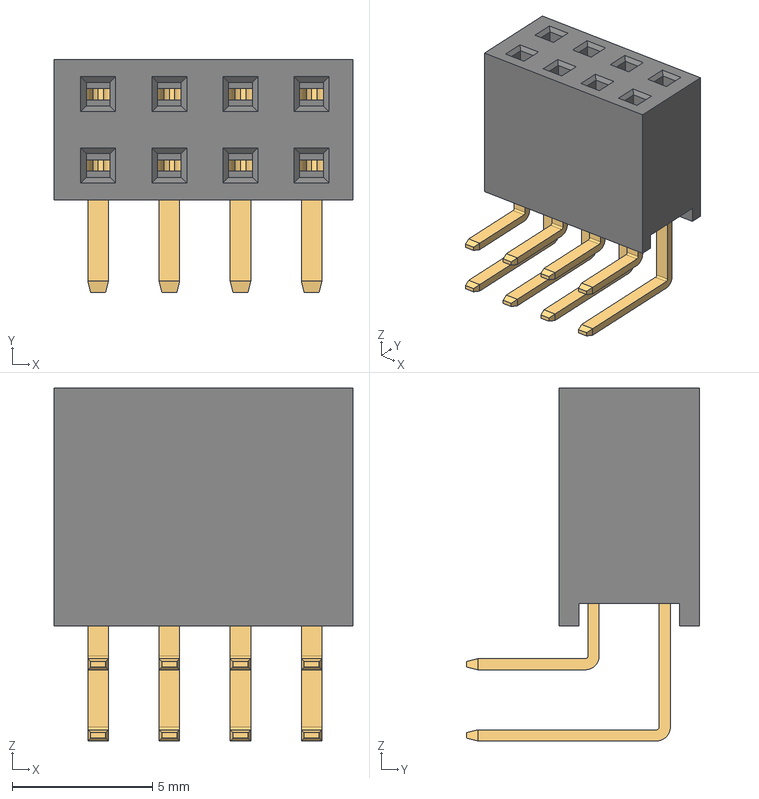
[picture p56: CAD file, 2024-05-18]
3dmodels/Connector/Wuerth_WR-PHD_613008243121.step
10.7 x 8.30 x 12.6 mm
6130xx243121_PIN x 4
6130xx243121_PIN_G x 4
