fl0m0/KiCad_libs/3dmodels/Connector/Wuerth_WR-PHD_61300421121.stp

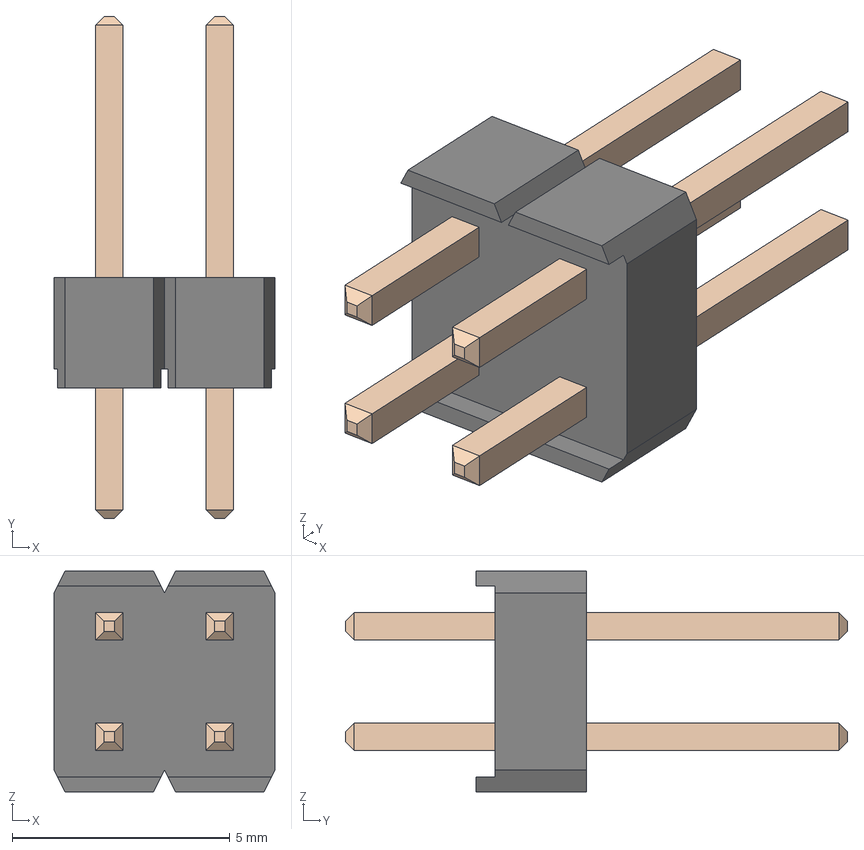
[picture p58: CAD file, 2024-05-05]
3dmodels/Connector/Wuerth_WR-PHD_61300421121.stp
5.08 x 11.5 x 5.08 mm
6130xx21121_PIN x 4
