fl0m0/KiCad_libs/3dmodels/Connector/Wuerth_WR-PHD_61300821821.stp

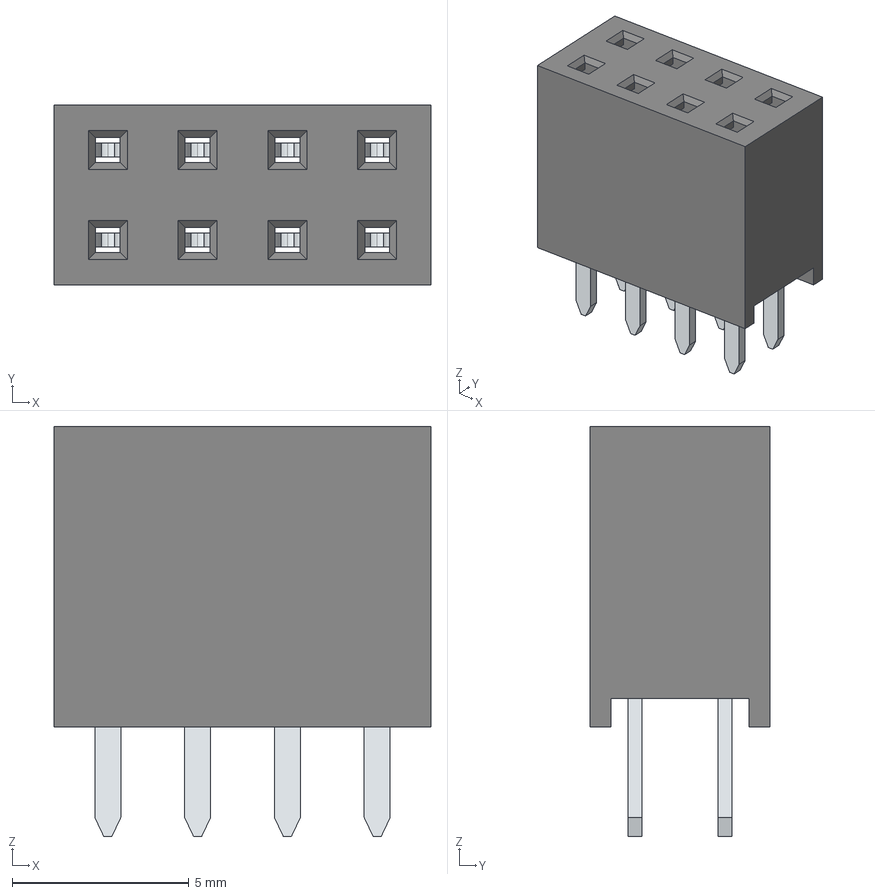
[picture p59: CAD file, 2024-05-05]
3dmodels/Connector/Wuerth_WR-PHD_61300821821.stp
10.7 x 5.08 x 11.6 mm
6130xx21821_PIN x 8
