fl0m0/KiCad_libs/3dmodels/Connector/BK-53.step

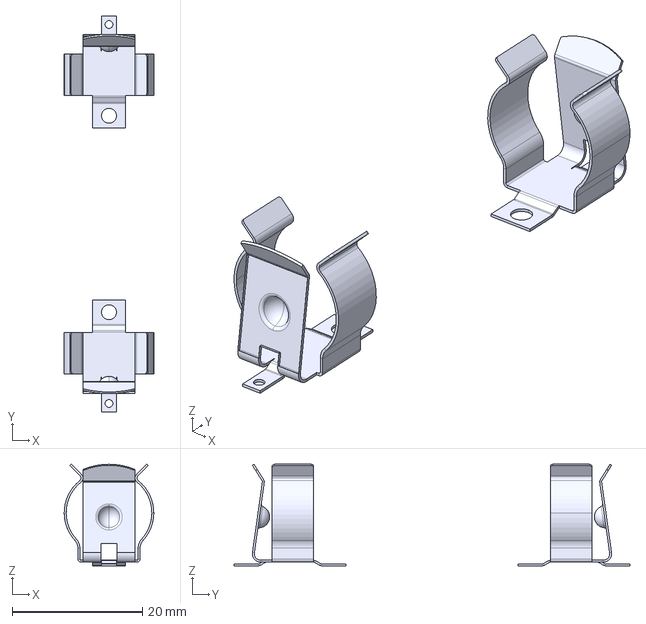
[picture p61: CAD file, 2023-11-26]
3dmodels/Connector/BK-53.step
13.8 x 60.8 x 15.6 mm
