fl0m0/KiCad_libs/3dmodels/Connector/JST_S2B-PH-SM4-TB.STEP

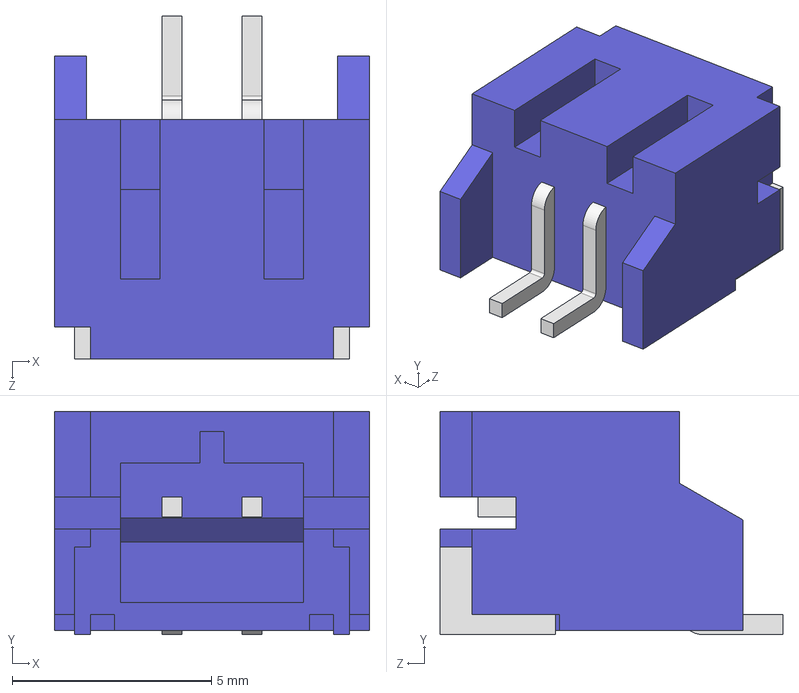
[picture p62: CAD file, 2023-08-20]
3dmodels/Connector/JST_S2B-PH-SM4-TB.STEP
7.90 x 5.60 x 8.60 mm
