fl0m0/KiCad_libs/3dmodels/Connector/SKS_PKI_10_A_banana_plug_red.step

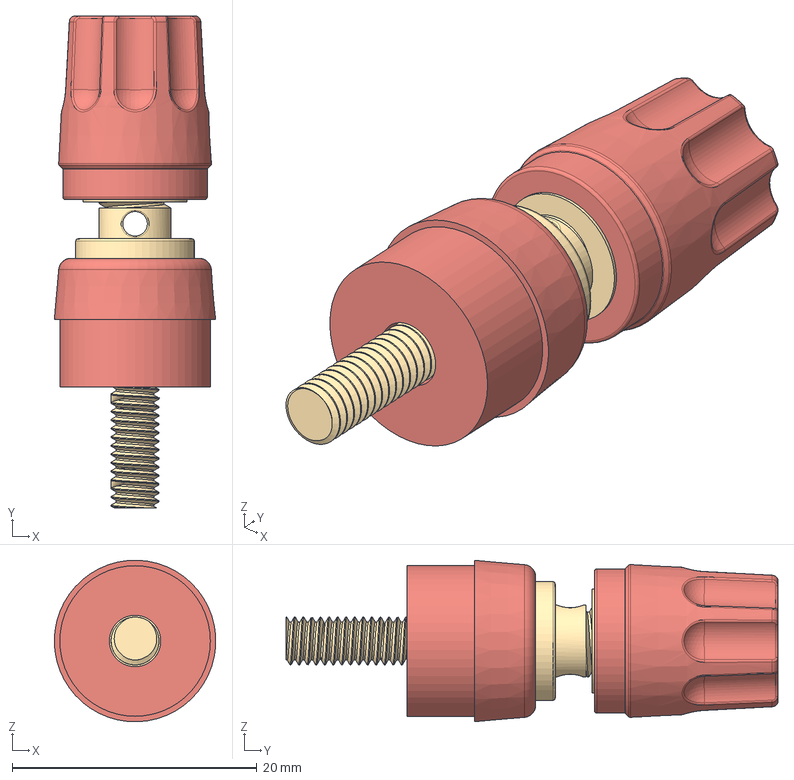
[picture p63: CAD file, 2023-06-18]
3dmodels/Connector/SKS_PKI_10_A_banana_plug_red.step
13.2 x 40.2 x 13.2 mm
