fl0m0/KiCad_libs/3dmodels/Connector/Potentiometer_Bourns_3296W_Vertical_no_leads.step

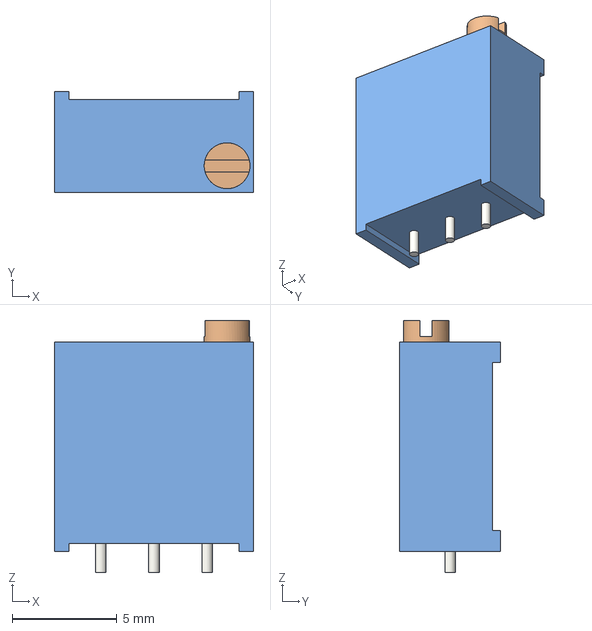
[picture p64: CAD file, 2023-06-06]
3dmodels/Connector/Potentiometer_Bourns_3296W_Vertical_no_leads.step
9.53 x 4.83 x 12.1 mm
