fl0m0/KiCad_libs/3dmodels/Connector/Wurth_SMA_60312002114503.stp

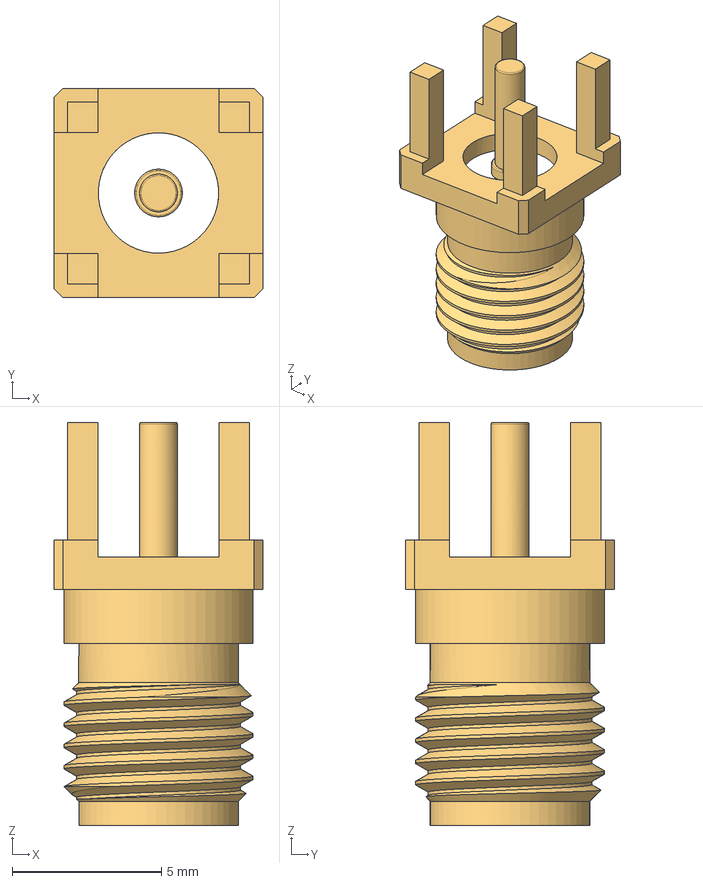
[picture p65: CAD file, 2023-06-06]
3dmodels/Connector/Wurth_SMA_60312002114503.stp
7.00 x 7.00 x 13.5 mm
