fl0m0/KiCad_libs/3dmodels/Connector/TE_9-1612503-1.stp

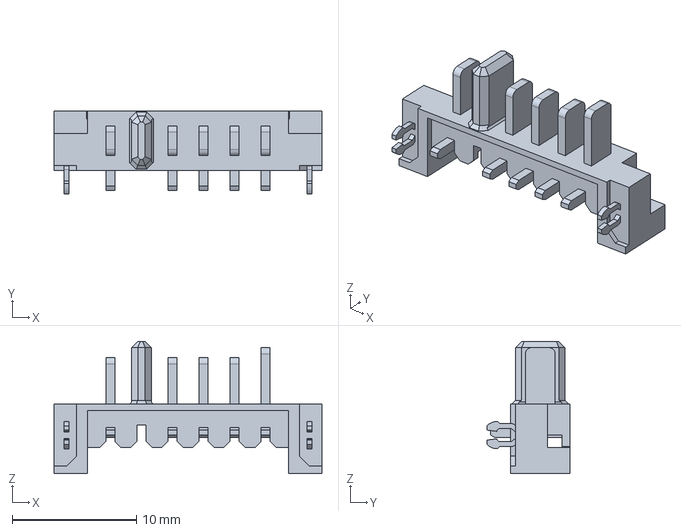
[picture p66: CAD file, 2023-05-30]
3dmodels/Connector/TE_9-1612503-1.stp
21.6 x 6.70 x 10.6 mm
