fl0m0/KiCad_libs/3dmodels/Connector/Wago_2061-1621_998-404.stp

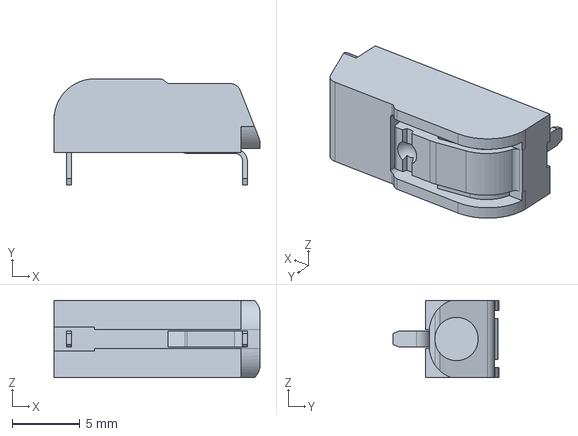
[picture p67: CAD file, 2023-05-30]
3dmodels/Connector/Wago_2061-1621_998-404.stp
15.2 x 7.85 x 5.70 mm
