fl0m0/KiCad_libs/3dmodels/Connector/TE_5787422-1.stp

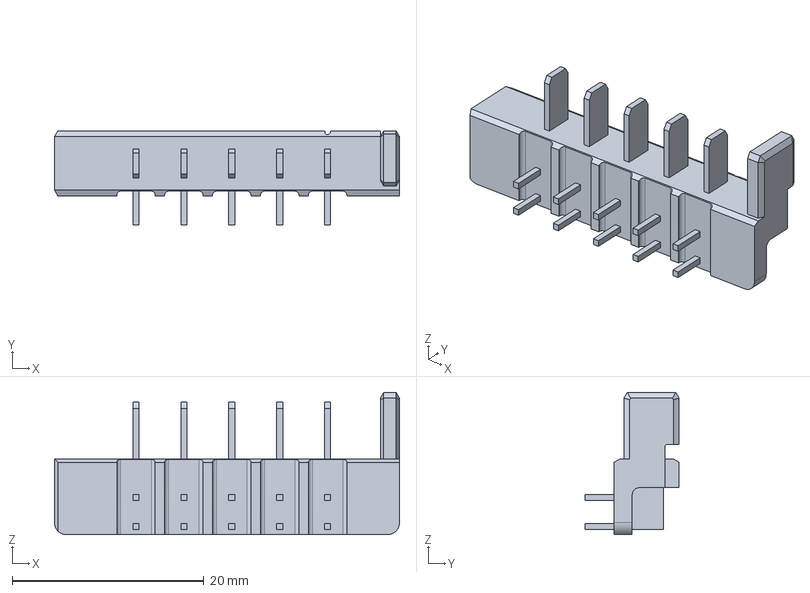
[picture p68: CAD file, 2023-05-30]
3dmodels/Connector/TE_5787422-1.stp
36.0 x 9.85 x 14.8 mm
