fl0m0/KiCad_libs/3dmodels/Connector/Molex_197054301.stp

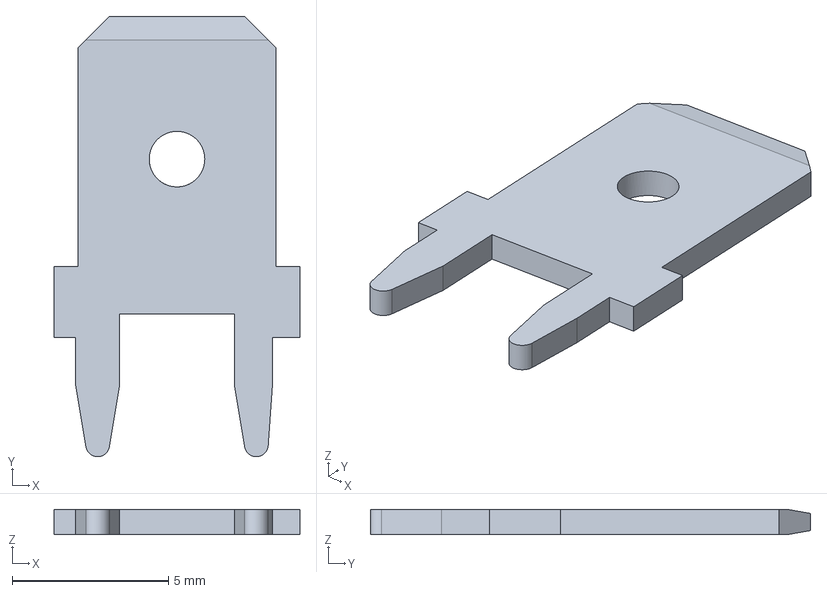
[picture p69: CAD file, 2023-05-30]
3dmodels/Connector/Molex_197054301.stp
7.87 x 14.1 x 0.813 mm
