fl0m0/KiCad_libs/3dmodels/Connector/TE_1747367-1.stp

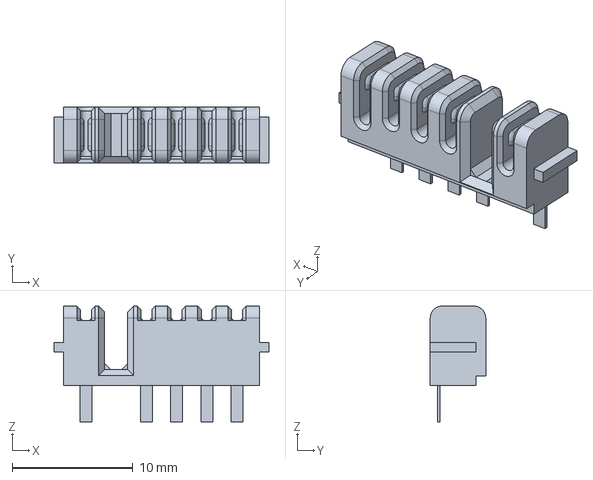
[picture p70: CAD file, 2023-05-30]
3dmodels/Connector/TE_1747367-1.stp
17.8 x 4.60 x 9.60 mm
