fl0m0/KiCad_libs/3dmodels/Connector/Metz_Connect_360291.stp

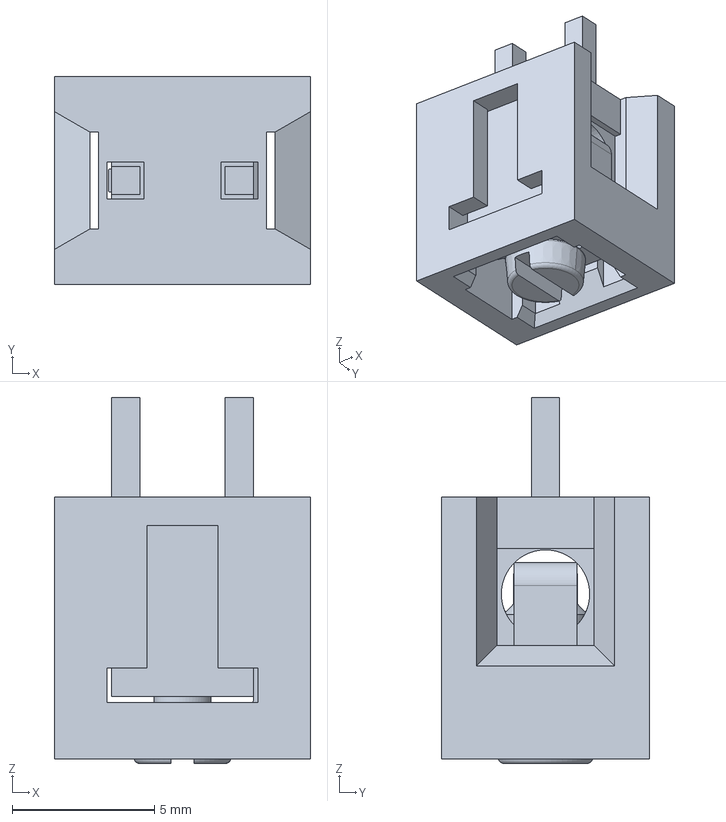
[picture p71: CAD file, 2023-05-30]
3dmodels/Connector/Metz_Connect_360291.stp
9.00 x 7.30 x 12.8 mm
