fl0m0/KiCad_libs/3dmodels/Connector/TE-146845-1.stp

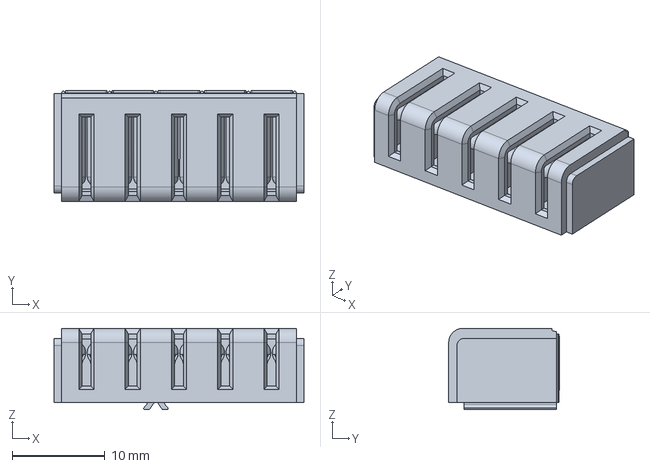
[picture p72: CAD file, 2023-05-30]
3dmodels/Connector/TE-146845-1.stp
27.0 x 12.0 x 8.80 mm
