fl0m0/KiCad_libs/3dmodels/Connector/Molex_197084011.stp

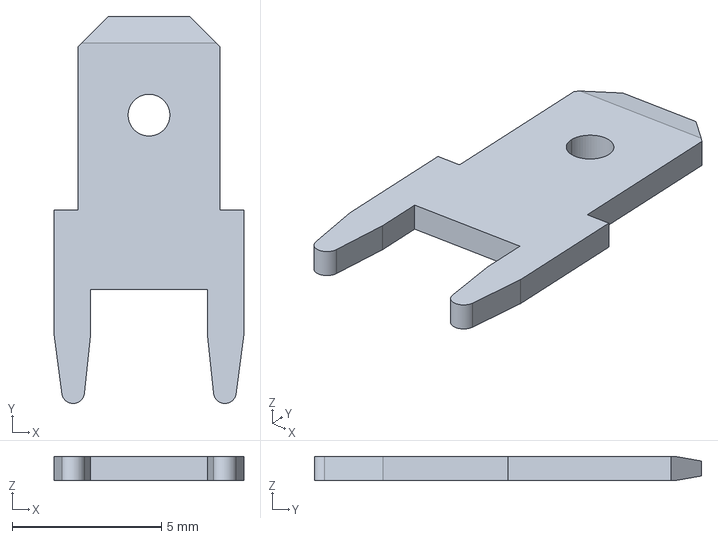
[picture p73: CAD file, 2023-05-30]
3dmodels/Connector/Molex_197084011.stp
6.35 x 13.0 x 0.813 mm
