fl0m0/KiCad_libs/3dmodels/Connector/TE_928814-1.stp

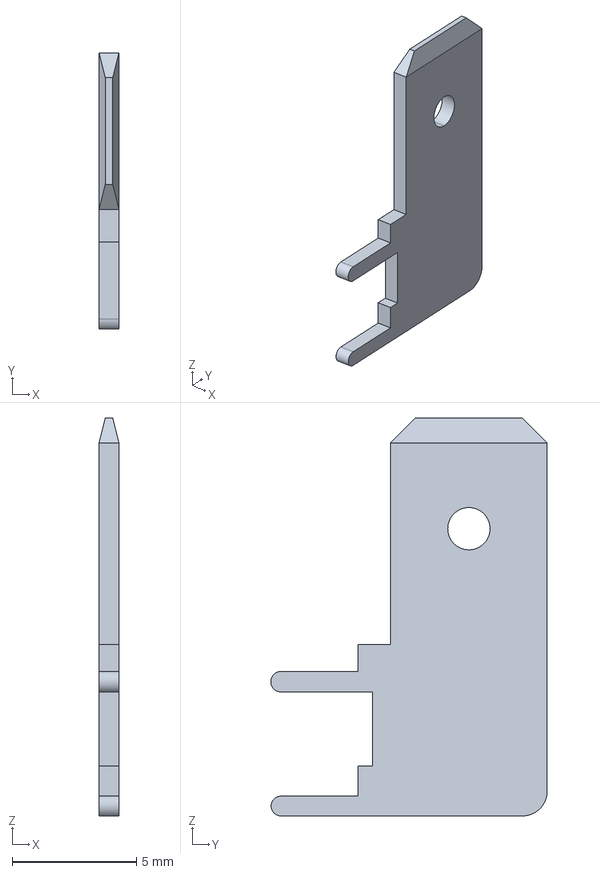
[picture p74: CAD file, 2023-05-30]
3dmodels/Connector/TE_928814-1.stp
0.8 x 11.1 x 16.0 mm
