fl0m0/KiCad_libs/3dmodels/Connector/Wurth_SKEDD_490107670612.stp

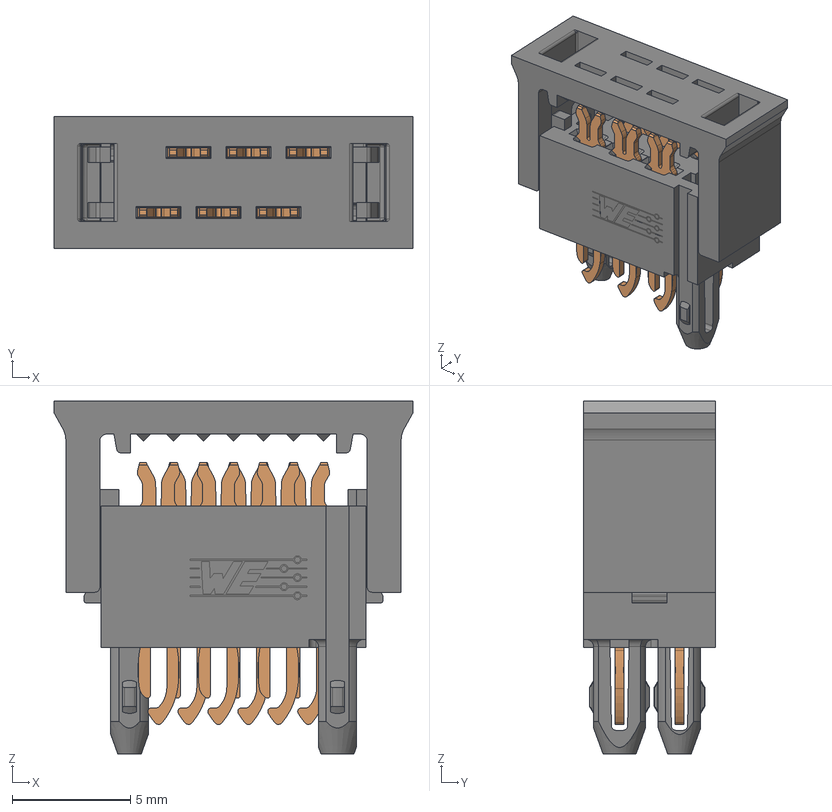
[picture p75: CAD file, 2023-05-30]
3dmodels/Connector/Wurth_SKEDD_490107670612.stp
15.2 x 5.60 x 15.0 mm
CT422_00.4.1.1_0 x 6
BS698_6_0
BS697_6_0
