fl0m0/KiCad_libs/3dmodels/Connector/Molex_530470410.stp

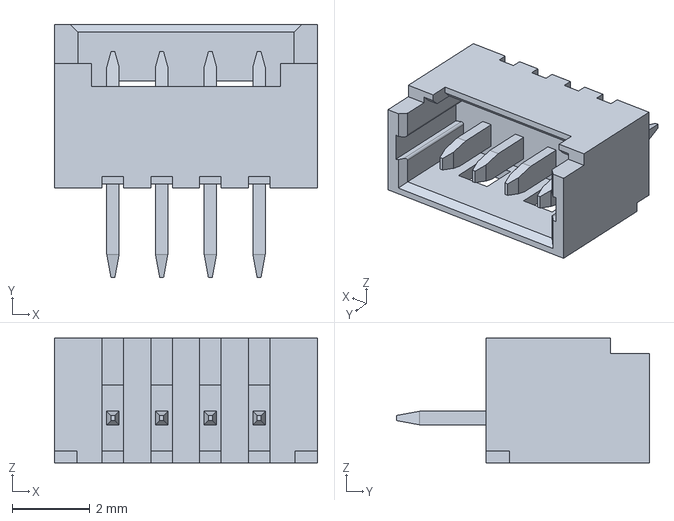
[picture p76: CAD file, 2023-05-30]
3dmodels/Connector/Molex_530470410.stp
6.75 x 6.50 x 3.20 mm
