fl0m0/KiCad_libs/3dmodels/Connector/Molex_2137160001.stp

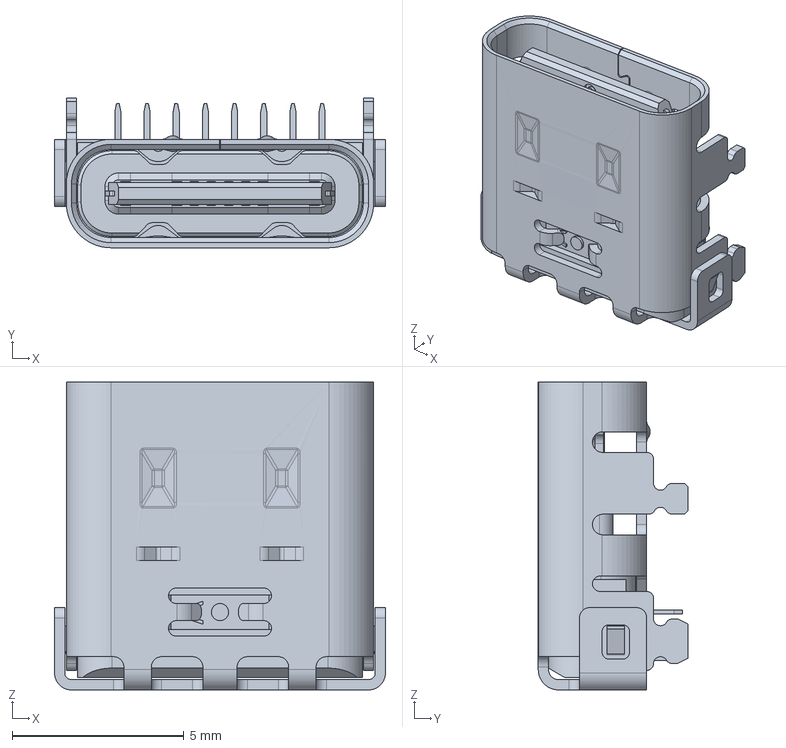
[picture p77: CAD file, 2023-05-30]
3dmodels/Connector/Molex_2137160001.stp
9.64 x 4.36 x 8.97 mm
