fl0m0/KiCad_libs/3dmodels/Connector/Wago_2061-621_998-404.stp

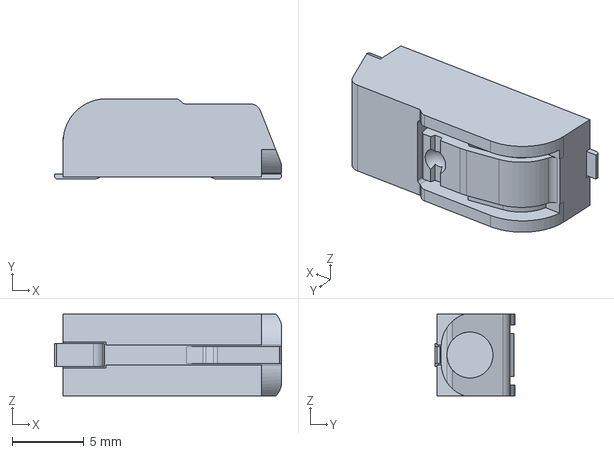
[picture p78: CAD file, 2023-05-30]
3dmodels/Connector/Wago_2061-621_998-404.stp
15.8 x 5.60 x 5.70 mm
