fl0m0/KiCad_libs/3dmodels/Connector/USB4135-GF-A.stp

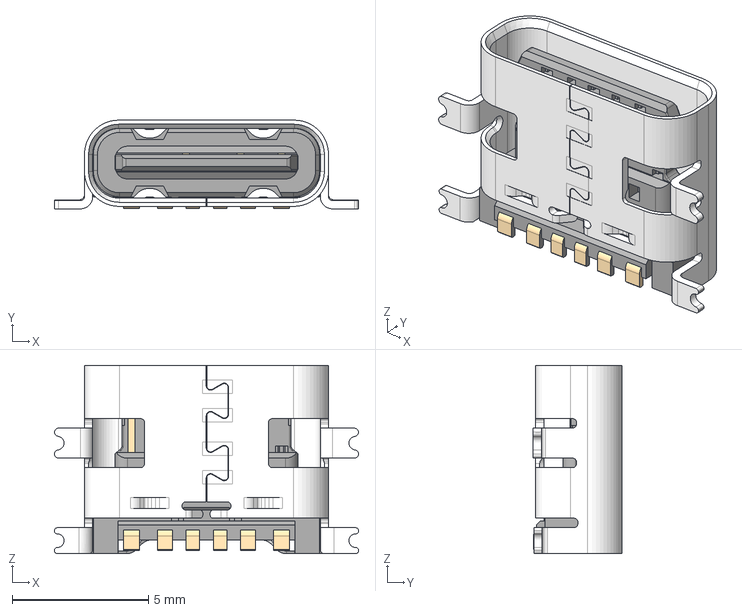
[picture p79: CAD file, 2023-05-30]
3dmodels/Connector/USB4135-GF-A.stp
11.1 x 3.25 x 6.90 mm
