fl0m0/KiCad_libs/(list of files, cad)

Other CAD files:
3dmodels/Connector/SKS_PKI_10_A_banana_plug_black.step
