fl0m0/KiCad_libs/(commit log)

2023-06-01 Add Dual MOSFET DMN2041LSD
2023-06-01 Add resistor, supervisor
2023-06-03 Add binding post, trim pot, resistor, switch
2023-06-04 Add LED, ferrite bead, SMA connector
2023-06-06 Add new parts
    [Potentiometer_Bourns_3296W_Vertical_no_leads.step, Wurth_SMA_60312002114503.stp]
2023-06-09 Add 5.1V zener diode, resistors
2023-06-10 Add JST PH connector, P-Channel FET
2023-06-18 Add binding post
    [WSON-12-1EP_3x2mm_P0.5mm_EP1x2.65.step]
2023-06-18 Add step models, fix trim pot error
    [SKS_PKI_10_A_banana_plug_black.step, SKS_PKI_10_A_banana_plug_red.step]
2023-07-02 Add AD841xA current sense amplifier
2023-07-23 Fix wrong ferrite bead footprint
2023-08-20 Add SB2-PH-SM4
    [JST_S2B-PH-SM4-TB.STEP]
2023-08-23 Fix 49R9 power rating, AD8418AWBRZ datasheet
2023-11-25 Add Symbol_User footprint library
2023-11-26 Add parts for xmas_tree
    [BK-53.step]
2023-11-27 Add 74HC4060 and ESD diode
2023-11-28 Add switch, test point, fuse
2023-12-01 Add RGB LED
2024-03-22 Fix capacitor value
2024-05-05 Add Wuert headers
    [Wuerth_WR-PHD_61300421121.stp, Wuerth_WR-PHD_61300821821.stp, Wuerth_WR-PHD_61301221821.stp]
2024-05-12 Add socket header, D-Flip-Flop
    [Wuerth_WR-PHD_61300421821.stp]
2024-05-18 Add 7 segment display, tactile switch
    [SA-SC56-11.STEP]
2024-05-18 Add LogicBricks, pin and socket header
    [Wuerth_WR-PHD_61300421821.stp, Wuerth_WR-PHD_61300821021.step, Wuerth_WR-PHD_613008243121.step]
2024-05-20 Update pin socket and header
2024-05-25 Add PT-15 potentiometer
    [PIHER_PT15-NV17.step]
2024-05-27 Add 5214 potentiometer shaft
    [PIHER_5214.step]
2024-05-30 Fix LogicBricks PowerCon, pin/socket header
2024-05-31 Add coded switch
    [Otax_KMx-xx.step]
2024-06-01 Add LED
2024-06-22 Add D6 switch, SN74HC109DR
    [CK_D6RLxxFxLFS.step]
2024-06-24 Add 74HC14D, fix 2x02 pin socket fab layer
2024-06-26 Update LogicBrick_BasePowerCon_1x1, USB connector
    * Fix BasePowerCon silkscreen, add VCC, GND labels
    * Make USB-C_Receptacle_GTC_USB4135-GF-A pads 0.2mm longer for handsoldering
2024-10-19 Add piano DIP switch
2024-10-19 Update DIP switch footprint
2024-10-24 Add coupled inductor, update BAT54 description
    [DP_04.step, WE-MCRI-1040.stp]
2024-10-27 Add TPS56455, update LEDs
2024-11-12 Add inductors, fix BD4836G and JST PH_S2B
    [L_Wurth_WE-MAPI-4030.step]
2024-11-29 Add MAPI inductors
    [L_Wurth_WE-MAPI-4020.step]
2024-12-01 Add inductor, slide switch
    [CUI_DEVICES_MSS-102568-14A-90-D005.step]
2025-03-12 Add flyback transformer
    [Wuerth_WE-FB_3751_EE35_18_10.step]
2025-03-15 Add flyback controller, MOSFET
    [Infineon_PG-TDSON-8-33.step]
2025-03-15 Add H-bridge driver
2025-03-17 Add Wuerth capacitors, XT30 connector
    [Amass_XT30U-F.step, CP_Wurth_WCAP-ASLI-D10L10.5.step, CP_Wurth_WCAP-ASLI-D12.5L14.step, CP_Wurth_WCAP-ASLI-D16L17.step, CP_Wurth_WCAP-ASLI-D4L5.5.step, CP_Wurth_WCAP-ASLI-D5L5.5.step, CP_Wurth_WCAP-ASLI-D6.3L5.5.step, CP_Wurth_WCAP-ASLI-D6.3L6.1.step]
2025-03-20 Add capacitor, 74 logic
2025-03-22 Add various components for SoundLaser
    [CUI_SJ2-359X-SMT.step, OMRON_B3FS_100x.step]
2025-03-23 Fix several symbol pin types
2025-03-23 Add probe test points
2025-03-30 Fix TP, transformer silkscreen
2025-10-17 Add C, MOSFET, opamp, regulator
    [BTT_TMC2209-V1.2.STEP]
2026-02-05 Add spring loaded connector, resistors, fix typo
    [Adam_Tech_PH2-3B-20-MVP-3345.step]
2026-02-07 Add OLED display, rotary encoder
    [PEC11R-4215F-Sxxxx.step, SSD1306_0.96_OLED.STEP]
2026-02-10 Add spring finger
    [TE_1551631-5.step]
2026-02-13 Add inductor
    [L_Bourns_SRP4020TA_4.45x4.06mm.step]
2026-02-21 Update OLED display
    [Wuerth_WR-PHD_61300411821.step]
2026-02-28 Add SpringFingerPads
2026-03-04 Update SpringFingerPads
2026-03-08 Add Wuerth pin header
    [Wuerth_WR-PHD_61300415721.step]
2026-03-09 Add OLED display connector
    [Harwin_M20-7810445.step]
2026-03-11 Update SSD1306_0.96_OLED_27x27.8mm_M20-7810445.kicad_mod
    Increase NPTH to copper clearance
2026-03-15 Add ESD diode, 56R resistor
2026-03-19 Update QFN-32, add resistor
    [Silicon_Labs_QFN-32-1EP_5x5mm_P0.5mm_EP3.6x3.6mm.step]
