fl0m0/KiCad_libs/(notices)

Notices in the files:
3dmodels/Inductor/L_Wurth_WE-MAPI-4020.step:
The information within the data (“Information”) has been provided to you free of charge for your use according to the terms of the
Creative Commons Attribution-ShareAlike 4.0 International Public License and remains the sole property of Würth Elektronik eiSos GmbH & Co. KG.
You are obliged to use the Information in accordance with the Creative Commons Attribution-ShareAlike 4.0 International Public License.
The following exception to the Creative Commons Attribution-ShareAlike 4.0 International Public License applies to your use of the Information:
To the extent that the creation of electronic designs that use 'Licensed Material' can be considered to be 'Adapted Material', then the copyright holder waives article 3 of
the license with respect to these designs and any generated files which use data provided as part of the 'Licensed Material'. You are free to use the library data in your
own projects without the obligation to share your project files under this or any other license agreement. However, if you wish to redistribute these libraries, or parts
3dmodels/Connector/Wago_2061-1621_998-404.stp:
FILE_NAME( 'p:/temp/worker_77/temp/exporttempdir_3236_224_rwjPn/format_1/2061-1621_998-404.stp', '2021-12-29T17:18:24', ( 'License CC BY-ND 4.0' ), ( 'CADENAS' ), ' ', 'PARTsolutions', ' ' );
3dmodels/Connector/Wago_2061-621_998-404.stp:
FILE_NAME( 'p:/temp/worker_52/temp/exporttempdir_5084_510_XVGJf/format_1/2061-621_998-404.stp', '2021-12-29T16:56:21', ( 'License CC BY-ND 4.0' ), ( 'CADENAS' ), ' ', 'PARTsolutions', ' ' );
3dmodels/Connector/USB4135-GF-A.stp:
author */ ('License CC BY-ND 4.0'),
3dmodels/Connector/Molex_197054301.stp:
FILE_NAME( 'C:/Users/KMIROS~1/AppData/Local/Temp/psolqas_10608_40.stp', '2020-05-06T21:03:40', ( 'License CC BY-ND 4.0' ), ( 'CADENAS' ), ' ', 'PARTsolutions', ' ' );
